jacob-rn-wallace/megadroid/SPEC.md

<!--
name: SPEC.md
type: specification
description: System specification: design intent and constraints
authority: authoritative
-->
# Megadroid — System Specification (SPEC)

**Status:** Authoritative  
**Scope:** Minimum Viable System (MVS)  
**Last rehydrated:** 2026-10-27

> **Note:** This document is a derived view of authoritative design data
> defined in `design/*.yaml`. See `REHYDRATE.md` for the rehydration process.

---

## 1. Purpose

This document defines the **authoritative system-level specification** for the Megadroid humanoid robot project.

It captures **design intent, architectural constraints, and locked assumptions** for the Minimum Viable System (MVS). All implementation details must conform to this specification unless explicitly revised here.

---

## 2. Project Goals

### 2.1 Ultimate Goal
To develop a **fully featured bipedal humanoid robot** with actuated legs, arms, and torso that can be built and iterated on by non-institutional builders at a fraction of the cost of traditional research humanoids.

### 2.2 Minimum Viable System (MVS) Goals
The MVS is intended to:
- Walk upright on flat ground
- Ascend and descend residential stairs using conservative, quasi-static gaits
- Maintain whole-body balance using limited actuation and software constraints
- Serve as a mechanically and electrically conservative foundation for future expansion

---

## 3. System Overview

### 3.1 Actuated Degrees of Freedom (MVS)

The following actuated degrees of freedom are derived directly from the
authoritative joint model defined in `design/joints.yaml`.

<!-- BEGIN AUTO-GENERATED: DOF -->
**Legs (×2):**
- Hip Yaw (yaw)
- Hip Pitch (pitch)
- Hip Roll (roll)
- Knee Pitch (pitch)
- Ankle Pitch (pitch)
- Ankle Roll (roll)

**Torso:**
- Torso Pitch (pitch)
- Torso Roll (roll)
- Torso Yaw (yaw)

**Total actuated DOF:** **15**
<!-- END AUTO-GENERATED: DOF -->

Each leg is a six-DOF leg: a three-axis hip (yaw, roll and pitch axes meeting at one point),
a knee, and a two-axis ankle. Hip yaw was added by the 2026-10-27 design revision; the legs
previously had five actuated DOF. The walking controllers do not yet use it (they hold it at
zero), so yaw steering and turning are not yet demonstrated in simulation.

### 3.2 Modular / Swappable Lower-Leg Assemblies (MVS vs Full System)

The robot supports modular lower-leg assemblies. The MVS lower-leg module includes both ankle pitch and ankle roll as actuated joints — see Section 5 for the reasoning. A passive, spring-centered ankle roll remains a possible future simplification, not a committed plan; the module boundary is kept compatible with it without requiring redesign of the pelvis, thigh, knee, or control stack.

### 3.3 Out-of-Scope (MVS)
- Arms: not installed in the MVS.

---

## 4. Anthropometrics

- Thigh length (hip → knee): defined in `design/geometry.yaml`
- Shin length (knee → ankle): defined in `design/geometry.yaml`
- Ankle-to-sole offset: defined in `design/geometry.yaml`

Overall body proportions are humanoid and sized to comfortably navigate residential environments (e.g., standard doorways, stairs).

---

## 5. Feet and Ground Contact

- Foot type (MVS module): Flat sole plate, resting on its bottom face, with a compliant
  sole pad for vertical shock absorption
- Ankle roll: sits between ankle pitch and the F/T sensor — see `design/joints.yaml`.
  It is **actuated**, kept that way deliberately for the time being: it was first
  actuated because a passive spring-centered ankle roll left the foot free to
  wobble uncontrolled and the gait fell over, and push-recovery investigation
  since then confirms actuated ankle/hip/torso roll axes are the physically
  correct authority for lateral disturbance recovery, matching capturability
  theory and real hardware. It is driven by the same generic position servo as
  every other joint. A passive, spring-centered ankle roll remains a possible
  future simplification, not a committed direction (see `tools/CLAUDE.md`).
- Function:
  - Vertical shock absorption (compliant sole pad)
  - Tolerance of foot placement errors
- End-of-limb sensing (6-DOF force/torque sensor per foot): see Section 7.3

---

## 6. Actuation

### 6.1 Motors
- All actuators use **775 brushed DC motors**
- Nominal motor voltage: **24 V**
- Motors mounted as proximally as possible to minimize distal inertia
- Total motor count (MVS): **15**

### 6.2 Gear Reduction
- Standardized gearbox classes reused across joints
- Gearbox class: **20:1 planetary**
- No joint uses a bespoke, one-off gearbox design
- Total drivetrain reduction: **80:1**
- All belt-driven transmission stages use HTD 5M timing belts with standardized width
  as defined in `design/geometry.yaml`.
- Belt stages provide additional reduction — belts exist to mount motors proximally, keeping mass off the distal links.
- Belt pitch and width are standardized across all joints to minimize part count,
  simplify sourcing, and improve serviceability.

### 6.3 Output Torque Envelope
- Peak sustained joint torque: **11.2 N·m** at every actuated joint
- A single envelope applies to all joints, since one motor and one gearbox class are used throughout
- This envelope is enforced in simulation as an actuator force limit, so simulated
  results reflect a bounded drivetrain rather than unlimited torque
- Motor stall torque, no-load speed, and drivetrain efficiency are currently
  estimates pending physical verification — see `design/actuation.yaml`, which also
  records what this model does **not** capture (torque–speed droop, thermal limits, belt compliance)
---

## 7. Sensors

### 7.1 Joint Position Sensing
- **Joint-mounted absolute encoders only**
- Encoders measure **true joint output angle**
- No motor-mounted encoders are permitted

### 7.2 Motor Sensing
- No motor current sensing
- No motor-side velocity sensing

### 7.3 Inertial Sensing
- **6-axis IMU** — gyroscope + accelerometer
- Mounting: pelvis, at the pelvis_center base frame origin
- **No magnetometer** — brushed DC motors make indoor magnetic heading unreliable; relative yaw is recovered from leg odometry against the planted foot, with slow absolute-yaw drift accepted
- IMU is **included in MVS cost accounting**
- Rationale: pelvis orientation and centre-of-mass velocity are required feedback states for every model-based balance method this design targets, and are not observable from joint encoders and foot force/torque alone
### 7.4 End-of-Limb Force/Torque Sensing
- Each foot includes a **6-DOF force/torque sensor**
- Form factor: hexagonal prism, 88.85mm across flats (inside a 107mm circumscribing diameter) × 57.544mm height
- Mounting: distal_face_of_lower_leg_module
- Sensor geometry is treated as a hard mechanical constraint
- F/T sensors are **excluded from MVS cost accounting**
- Rationale: excluded because the real cost is near zero, not because it is out of scope — each 6-DOF sensor is built from six load cells harvested from used Wii Fit Balance Boards (four bar-type cells per board), Stewart-platform arranged between two machined discs; three boards supply both feet's sensors at well under $100 each. The signal-chain electronics this requires are a separate, real cost not covered by this exclusion.

---

## 8. Control Architecture

### 8.1 Control Mode
- **Position-only control**
- No torque control
- No impedance control

### 8.2 Software Constraints
Stability and hardware protection are enforced through:
- Joint velocity limits
- Joint acceleration limits
- Gait timing constraints
- Brownout-aware behavior

---

## 9. Electrical Power System

### 9.1 Battery (Excluded from Cost Target)
- Model: **Toro 88675**
- Nominal voltage: **60 V**
- Capacity: **7.5 Ah**
- Energy: **405 Wh**

### 9.2 Power Distribution
- Single central DC/DC converter
- Conversion: **60 V → 24 V**
- Continuous current capability: ≥ **50 A**
- 24 V bus distributed to all motor drivers

### 9.3 Protection Philosophy
- Hardware current limiting at motor drivers
- Single main fuse on 60 V rail
- No per-motor DC/DC converters

---

## 10. Control Hardware Stack

### 10.1 High-Level Control
- **Raspberry Pi (Linux SBC)**
- Responsibilities:
  - Gait state machine
  - Trajectory generation
  - Supervisory control
  - Logging and debugging

### 10.2 Real-Time Control
- **3 × Waveshare RP2350-CAN boards**
  - Left leg controller
  - Right leg controller
  - Torso controller

### 10.3 Communications
- CAN bus
- Nominal bitrate: **500 kbps**

---

## 11. Cost Constraints

- **Target total system cost:** Comparable to a capable hobbyist desktop PC —
  approximately **$800–$1,500 USD** as of 2026
- The constraint is hobbyist accessibility, not a specific dollar figure. The
  question to ask of any component choice is: could an individual hobbyist
  justify this purchase without it being a significant financial decision?
- Explicit exclusions:
  - Battery
  - End-of-limb force/torque sensors
- Cost tracking is maintained in `BOM.csv`

---

## 12. Explicit Exclusions (MVS)

The following are intentionally excluded from the MVS:
- Arms or manipulators
- Torque or impedance control
- Motor current telemetry
- High-bandwidth force feedback loops
- Aesthetic-driven enclosure geometry

---

## 13. Design Philosophy

Megadroid prioritizes:
- Mechanical conservatism
- Electrical simplicity
- Software-enforced safety and stability
- Clear load paths and inspectable structures
- Incremental extensibility without redesign

For the full rationale behind these principles and the project's design
decisions, see `PHILOSOPHY.md`.

---

## 15. Change Control

### 15.1 Purpose

This section defines the **formal process by which changes to the Megadroid system specification are proposed, reviewed, and adopted**.

The intent is to:
- Prevent uncontrolled design drift
- Maintain consistency across `SPEC.md`, `MECH.md`, and `BOM.csv`
- Ensure that all changes are intentional, documented, and traceable

This process is intentionally lightweight and optimized for a small, fast-moving project.

### 15.2 Change Authority

- **`SPEC.md` is the highest authority** for the Megadroid MVS.
- Any change that alters:
    - system capabilities,
    - degrees of freedom,
    - architectural assumptions,
    - control philosophy,
    - or cost constraints
      **must be reflected in `SPEC.md`.**

`MECH.md` and `BOM.csv` **must not contradict `SPEC.md`**.

### 15.3 Changes Requiring a SPEC Revision

A modification **requires a `SPEC.md` update** if it affects any of the following:
- Actuated or passive degrees of freedom
- Joint limits or kinematic conventions
- Control mode (e.g., position vs torque)
- Power architecture or voltage levels
- Sensor strategy (e.g., encoder placement, sensing modality)
- Modularity assumptions (e.g., swappable lower-leg modules)
- Explicit inclusions or exclusions in the MVS
- Cost target or cost exclusions

Pure implementation details that do **not** affect these constraints belong in `MECH.md` or `BOM.csv` only.

### 15.4 Change Workflow

All design changes follow this sequence:

1. Proposal
   - Identify the motivation for change (e.g., feasibility, cost, packaging, precedent)
   - Articulate the proposed modification clearly
2. Evaluation
   - Assess impact on:
       - mechanical design
       - control strategy
       - cost target
       - future extensibility
   - Compare against relevant prior art where applicable
3. Specification Update
	- Modify `SPEC.md` to reflect the new or revised constraint.
    - Changes must be explicit and unambiguous.
4. Propagation
	- Update `MECH.md` and/or `BOM.csv` as required to conform to the new SPEC.
    - No document may remain in conflict with `SPEC.md`.
5. Commit
	- Commit changes to the repository with a clear message describing:
        - what changed
        - why it changed
        - what assumptions were updated or removed
   
### 15.5 Locked vs Revisable Decisions

Design decisions fall into two categories:

**Locked decisions**
- Explicitly stated as "locked" in `SPEC.md` or `MECH.md`
- Not revised without strong justification
- Changes require a SPEC revision and a commit explaining the rationale

**Revisable decisions**
- Identified as implementation details
- May evolve without changing `SPEC.md`
- Must remain compliant with all locked constraints

When in doubt, treat a decision as **locked**.

### 15.6 Versioning and Tags

- Git tags represent **stable design plateaus**, not incremental progress.
- A tag should only be created when:
    - `SPEC.md`, `MECH.md`, and `BOM.csv` and internally consistent
    - No known contradictions exist between documents

Tags serve as historical reference points and rollback anchors.

### 15.7 Conversational and External Inputs

Design discussions, simulations, analyses, and external references (including LLM-assisted reasoning) are **non-authoritative inputs**.

A design decision becomes authoritative **only when it is written into `SPEC.md` and committed to the repository**.

### 15.8 Guiding Principle

> If a decision matters, it must be written down.
> If it is written down, it must be respected.

This change control process exists to ensure that Megadroid evolves deliberately, not accidentally.

---

## 16. Authority

This document is **authoritative**.

All mechanical, electrical, and software implementations must conform to this specification unless a revision is made here.

Detailed mechanical implementation is defined in `MECH.md`.
