jacob-rn-wallace/megadroid/MECH.md

<!--
name: MECH.md
type: mechanical-design
description: Mechanical design: joints, structure, actuators, loads
authority: derived
-->
# Megadroid — Mechanical Design (MECH)

**Status:** Authoritative (MVS)  
**Scope:** Mechanical implementation details for the Minimum Viable System  
**Last rehydrated:** 2026-10-27

> **Note:** This document is a derived view of authoritative design data
> defined in `design/*.yaml`. See `REHYDRATE.md` for the rehydration process.

---

## 1. Purpose

This document defines the **authoritative mechanical design** of the Megadroid humanoid robot for the Minimum Viable System (MVS).

It specifies _how_ the system described in `SPEC.md` is physically realized, including joint layout, structural concepts, actuator placement, and load paths. Any mechanical implementation must conform to this document unless explicitly revised here.

---

## 2. Overall Mechanical Architecture

### 2.1 Structural Philosophy

Megadroid adopts a **mechanically conservative, inspection-friendly architecture** based on:
- Explicit load paths
- Double-shear joints wherever possible
- Proximal motor placement
- Reuse of structural and actuation patterns

The robot is organized around three primary structural modules:
- **Torso module** (houses power electronics and torso actuators)
- **Left leg module**
- **Right leg module**

Arms are excluded from the MVS. Ankle pitch and ankle roll are both actuated — ankle
roll is kept actuated deliberately for the time being (see Section 5.4).

---

## 3. Leg Architecture (MVS)

### 3.1 Degrees of Freedom per Leg

Each leg implements **six actuated DOF**:
- Hip yaw
- Hip roll
- Hip pitch
- Knee pitch
- Ankle pitch
- Ankle roll — **interim actuation** (see Section 5.4): temporarily motorized rather
  than passive/spring-centered, pending walking-controller work. See
  `design/joints.yaml` (`ankle_roll`).

Hip yaw was added in the 2026-10-27 design revision, taking the legs from five to six
actuated DOF. See Section 5.2.

The lower-leg module's knee-to-module mechanical interface is preserved, so a future
variant can return ankle roll to a passive, spring-centered joint without redesigning
the pelvis, thigh, knee, or ankle pitch assembly.

---

## 4. Leg Structural Construction

### 4.1 Twin-Rail / Box-Bulkhead Construction

Each leg segment (thigh and shank) is constructed as a **stiff boxed structure** using **twin longitudinal side rails** connected by **transverse bulkheads**, rather than a single tube or cosmetic shell.

- Rails are flat plates (e.g., aluminum or steel) arranged in parallel
- Bulkheads act as:
  - Structural diaphragms
  - Shaft and bearing mounting points
  - Load-transfer elements between rails
- Inner-face spacing between rails: defined in `design/geometry.yaml` (locked)

This architecture provides:
- High bending stiffness
- Good torsional rigidity when skinned
- Tolerance to fabrication variability
- Clear, inspectable load paths

Where beneficial, thin cover plates or printed skins may be added to form a closed box section and improve torsional stiffness.

### 4.2 Thigh Segment

- Length (hip → knee): defined in `design/geometry.yaml`
- Contains:
  - Hip pitch output shaft
  - Hip roll output shaft (carried on the hip yaw link above the thigh, Section 5.2)
  - Proximal portion of knee actuator (if applicable)

Motors are mounted as proximally as possible to reduce distal inertia.

### 4.3 Lower-Leg Module (Shank)

The lower-leg module consists of the complete shank structural assembly from the knee output interface down to its distal termination bulkhead.

**Structural stack (proximal → distal):**
1. Knee output interface
2. Shank twin rails (length defined in `design/geometry.yaml`)
3. Ankle pitch joint assembly
4. Ankle roll joint assembly (actuated — interim, see Section 5.4)
5. Distal termination bulkhead
6. F/T sensor (mounted to distal bulkhead face)
7. Foot sole plate (MVS)

**Key characteristics:**
- Modular: swappable at knee interface without redesigning pelvis, thigh, or knee
- MVS configuration: includes actuated ankle pitch and ankle roll (ankle roll's
  actuation is interim — see Section 5.4)
- Future configurations: planned to return ankle roll to a passive, spring-centered
  joint while preserving the knee-to-module interface
- Contains knee pitch output shaft
- Distal bulkhead provides mounting face for end-of-limb F/T sensor

---

## 5. Joint Design

### 5.1 General Joint Requirements

All joints must:
- Use **joint-mounted absolute encoders**
- Measure true joint output angle
- Be serviceable and inspectable
- Carry primary loads in double shear

Motor-mounted encoders are explicitly disallowed.

This applies uniformly regardless of whether a given joint is actuated in the current
configuration — true output angle is needed for accurate foot-orientation and ZMP
calculations either way, so every joint carries the same joint-mounted absolute
encoder.

### 5.2 Hip Joint Assembly

The hip consists of **three orthogonal rotational axes** that meet at one point, in this
chain order from the pelvis outward:

- **Hip yaw** (turning the leg about the vertical axis)
- **Hip roll** (lateral balance)
- **Hip pitch** (sagittal plane motion)

Key characteristics:
- Motors mounted proximally (pelvis, hip yaw link or upper thigh)
- The hip yaw motors sit in the pelvis. The hip roll motor rides on the hip yaw link and
  turns with it, so the hip yaw output shaft carries the roll motor's weight
- Gearboxes coupled directly to joint output shafts
- Bearings sized for combined radial and moment loads

Hip yaw is an actuated MVS joint (design revision 2026-10-27; it was previously described
here as present but locked). The current walking controllers hold it at zero, so turning is
not yet demonstrated in simulation.

Hip joint output shafts use standardized shafting as defined in `design/geometry.yaml` (locked) to standardize bearings, hubs, and pulley bores.

### 5.3 Knee Joint Assembly

- Single-axis revolute joint (pitch)
- Actuator mounted proximally in the thigh
- Torque transmitted across the joint via a rigid shaft
- Bearings sized primarily for bending loads from stance phase

### 5.4 Lower-Leg Module and Foot Interface (MVS)

The MVS lower-leg module includes actuated ankle pitch and ankle roll, kept actuated deliberately for the time being, while preserving the mechanical interface for a possible future reversion to a passive design.

**Module definition:**
The lower-leg module includes the shank twin rails, ankle pitch joint assembly, ankle roll joint assembly, all bulkheads, and the distal termination bulkhead that serves as the mounting face for the F/T sensor.

**Structural boundaries:**
- Proximal: knee output interface
- Distal: F/T sensor mounting face (distal termination bulkhead)

**MVS configuration:**
- Ankle pitch actuated
- Ankle roll actuated — **interim** (see `design/joints.yaml`): simulation found the
  walking controllers have no lateral feedback, so a passive spring-centered ankle
  roll left the gait unstable; temporarily motorized pending either a validated
  spring or real local lateral feedback (`tools/CLAUDE.md`)
- Flat sole foot plate mounted distal to F/T sensor

**Future compatibility:**
A future lower-leg module is planned to return ankle roll to a passive,
spring-centered joint while preserving:
- Same knee-to-module mechanical interface
- Same joint encoder strategy
- Compatibility with pelvis, thigh, and knee assemblies

---

## 6. End-of-Limb Force/Torque Sensor Integration

Each foot has one **6-DOF force/torque sensor** that measures ground reaction forces and moments.

**Mounting and integration:**
- Sensor is mounted directly to the distal termination bulkhead of the lower-leg module
- Located immediately proximal to the foot/end-effector, distal to both ankle pitch and ankle roll
- Form factor: hexagonal prism, 88.85mm across flats (inside a 107mm circumscribing diameter) × 57.544mm height (defined in `design/sensors.yaml`)
- Mechanical constraint: treated as hard structural envelope

**Load path requirements:**
- Ground reaction forces must pass axially through the sensor
- Structural design must avoid imposing parasitic bending moments on sensor body
- Sensor sits between distal bulkhead and foot in the structural stack

**Cost accounting:**
F/T sensors are mechanically required but **excluded from cost accounting** —
not because they are out of scope, but because the real cost is near zero.
Each sensor is built from six load cells harvested from used Wii Fit Balance
Boards (four bar-type cells per board), arranged Stewart-platform style
between two custom-machined aluminium discs within the envelope above; three
boards (twelve cells) supply both feet's sensors at well under $100 each.
The signal-chain electronics this sourcing needs (multi-channel amplification
and fast acquisition) are a separate, real cost not covered by this exclusion
— see `docs/P4_JOINT_TEST_RIG.md`.

---

## 6a. Inertial Sensor Integration

A single **6-axis IMU** (gyroscope + accelerometer) is mounted at the pelvis.

**Mounting and integration:**
- Location: pelvis, at the pelvis_center base frame origin
- Co-locating the IMU with the base frame origin means its measurements need no transform before use — readings are already expressed about the frame the kinematics are defined in
- Should be mounted on the pelvis structure rather than on a motor bracket, to keep brushed-motor vibration out of the accelerometer signal
- Rigid mounting is required: any compliance between the IMU and the pelvis structure appears directly as orientation error

**Function:**
Provides pelvis orientation and angular rate. Together with joint encoders and the
foot force/torque sensors, this is what makes centre-of-mass position and velocity
observable — neither is recoverable from encoders and foot sensing alone, and both are
required feedback states for the balance methods this design targets.

**Cost accounting:**
The IMU is **included in cost accounting**, unlike the F/T sensors.
---

## 7. Actuator Integration

### 7.1 Motors

- All actuators use **775 brushed DC motors**
- Motors mounted proximally where feasible
- Motors mechanically isolated from bending loads

### 7.2 Gearboxes

- Modular gearbox designs reused across joints
- Gearbox class: **20:1 planetary**, reused at every actuated joint
- Only a small number of gearbox ratios permitted
- No joint-specific one-off gearbox designs

Exact gearbox part selections are documented in `BOM.csv`.

### 7.3 Belt Standard (Locked)

All belt stages in Megadroid use HTD 5M timing belts with standardized width as defined in `design/geometry.yaml`.

Belt stages provide additional reduction on top of the gearbox.
### 7.4 Output Torque Envelope

- Total reduction: **80:1**
- Peak joint torque: **11.2 N·m**, uniform across all actuated joints
- Maximum joint speed: **19.6 rad/s**

This envelope bounds what any control strategy can demand of a joint, and is enforced
as an actuator limit in the generated simulation model. Motor stall torque, no-load
speed, and drivetrain efficiency are estimates pending physical measurement — see
`design/actuation.yaml` for the values, their provenance, and the effects this model
deliberately does not capture (torque–speed droop, thermal limits, belt compliance,
gear backlash).

---

## 8. Torso Mechanical Design

### 8.1 Degrees of Freedom

The torso implements **three actuated DOF**:
- Pitch
- Roll
- Yaw

### 8.2 Structural Role

The torso structure:
- Serves as the primary load path between legs
- Houses power electronics and controllers
- Provides mounting for torso actuators

The torso must maintain stiffness sufficient to prevent coupling between leg motions through structural flex.

---

## 9. Materials and Fabrication

### 9.1 Preferred Materials

- Aluminum plate for primary structure
- Steel shafts and fasteners
- Polymer or printed parts only where loads are low

Pultruded carbon tubes are explicitly excluded from the MVS.

### 9.2 Fabrication Philosophy

Designs should favor:
- Flat plate machining or waterjet
- Off-the-shelf bearings and fasteners
- Minimal custom machining
- Tolerance-insensitive assemblies

---

## 10. Mechanical Constraints

- Must fit through standard residential doorways
- Must tolerate quasi-static stair climbing loads
- Must support conservative gait speeds

---

## 11. Authority

This document is a **derived view** of the authoritative design data in `design/*.yaml` and `SPEC.md`.

Any mechanical change must first be reflected in the appropriate YAML files and `SPEC.md`, then propagated here via rehydration.
