jacob-rn-wallace/megadroid/hardware/ft_sensor/cad/megadroid_ft_v0/features.csv

member | cell_on | tilt_from_cap_normal_deg | azimuth_deg | u_x | u_y | u_z | wedge_hole_entry_x | wedge_hole_entry_y | wedge_hole_entry_z | boss_hole_entry_x | boss_hole_entry_y | boss_hole_entry_z
0 | bottom | 54.50 | 111.0 | -0.2918 | 0.7600 | 0.5807 | 25.591 | 25.604 | 5.020 | 23.068 | 32.178 | 46.893
1 | top | 54.50 | -69.0 | 0.2918 | -0.7600 | -0.5807 | -25.591 | -25.604 | 46.524 | -23.068 | -32.178 | 4.651
2 | bottom | 54.50 | -129.0 | -0.5123 | -0.6327 | 0.5807 | -34.970 | 9.361 | 5.020 | -39.401 | 3.888 | 46.893
3 | top | 54.50 | 51.0 | 0.5123 | 0.6327 | -0.5807 | 34.970 | -9.361 | 46.524 | 39.401 | -3.888 | 4.651
4 | bottom | 54.50 | -9.0 | 0.8041 | -0.1274 | 0.5807 | 9.378 | -34.965 | 5.020 | 16.333 | -36.066 | 46.893
5 | top | 54.50 | 171.0 | -0.8041 | 0.1274 | -0.5807 | -9.378 | 34.965 | 46.524 | -16.333 | 36.066 | 4.651
