jacob-rn-wallace/megadroid/BOM.csv

<!--
name: BOM.csv
type: data
description: Bill of materials and cost tracking for MVS
authority: derived
-->
Subsystem | Item | Quantity | UnitCostUSD | ExtendedCostUSD | CostIncluded | Notes
Actuation | 775 Brushed DC Motor | 15 | 18 | 270 | Yes | Identical motor used for all actuated joints — includes hip_yaw (added 2026-10-27 for 6-DOF legs) and ankle_roll (temporarily actuated | see design/joints.yaml)
Actuation | 20:1 Planetary Gearbox (775 compatible) | 15 | 25 | 375 | Yes | Standardized gearbox class reused across joints
Actuation | Secondary Belt Reduction Components (4:1) | 15 | 12 | 180 | Yes | 4:1 belt on ALL actuated joints incl. ankles — ankle-less scope never walks at any ratio (design/actuation.yaml)
Sensors | Absolute Joint Encoder | 15 | 8 | 120 | Yes | Joint-mounted output encoders — all 15 actuated joints (design/sensors.yaml)
Sensors | 6-Axis IMU (gyro + accelerometer) | 1 | 15 | 15 | Yes | Pelvis-mounted at base frame origin; no magnetometer (design/sensors.yaml)
Control | Waveshare RP2350-CAN Controller | 3 | 22 | 66 | Yes | Left leg | right leg | torso
Control | Raspberry Pi (Linux SBC) | 1 | 45 | 45 | Yes | High-level control and supervision
Power | 60V to 24V DC/DC Converter (≥50A) | 1 | 85 | 85 | Yes | Centralized power conversion
Power | Main Fuse and Power Distribution Hardware | 1 | 25 | 25 | Yes | 60V rail protection and wiring
Structure | Aluminum Plate Stock (Legs + Torso) | 1 | 120 | 120 | Yes | Twin-rail box-bulkhead construction
Structure | Bearings | Shafts | Fasteners (Bulk) | 1 | 110 | 110 | Yes | Shared across joints and structure
Feet | Flat Sole Plate Assembly (compliant sole pad) | 2 | 30 | 60 | Yes | Rigid plate + compliant pad for vertical shock absorption
Feet | 6-DOF Force/Torque Sensor | 2 | 0 | 0 | No | Excluded because real cost is near-zero — built from 6 harvested Wii Fit Balance Board load cells each (design/sensors.yaml)
Power | Toro 88675 Battery Pack | 1 | 0 | 0 | No | Excluded from cost target per SPEC
TOTAL
