jacob-rn-wallace/megadroid/hardware/ft_sensor/cad/megadroid_ft_v0/sensor_assembly.step

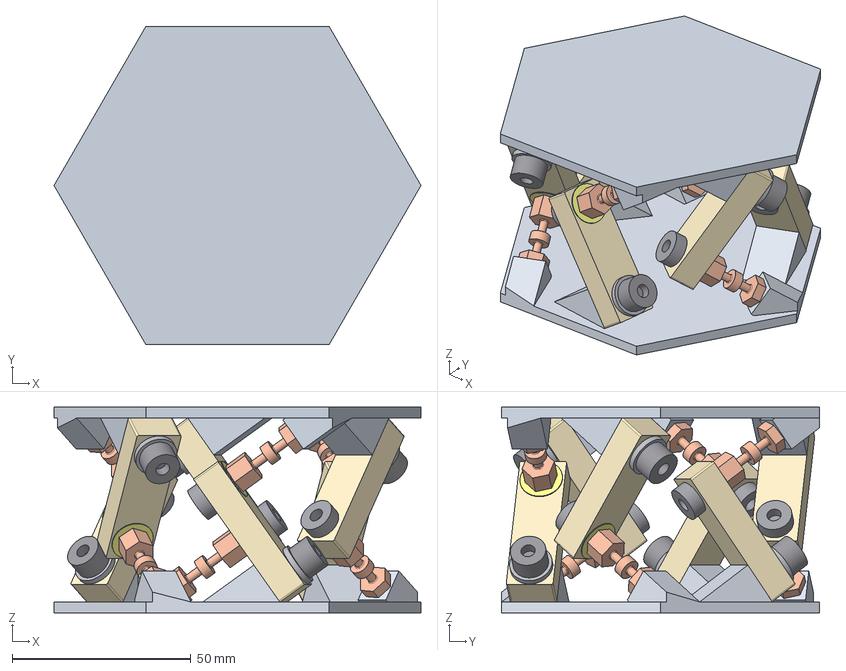
[picture p1: CAD file, 2026-10-21]
hardware/ft_sensor/cad/megadroid_ft_v0/sensor_assembly.step
102.6 x 88.8 x 57.5 mm
cap_bottom
cap_top
cell_0
cell_1
cell_2
cell_3
cell_4
cell_5
rod_5 x 6
bolt_0
washer_fixed_0
shim_0
screw_free_0
bolt_1
washer_fixed_1
shim_1
screw_free_1
bolt_2
washer_fixed_2
shim_2
screw_free_2
bolt_3
washer_fixed_3
shim_3
screw_free_3
bolt_4
washer_fixed_4
shim_4
screw_free_4
bolt_5
washer_fixed_5
shim_5
screw_free_5
