jacob-rn-wallace/megadroid/hardware/ft_sensor/cad/bench_rigs/parts/block_a2.step

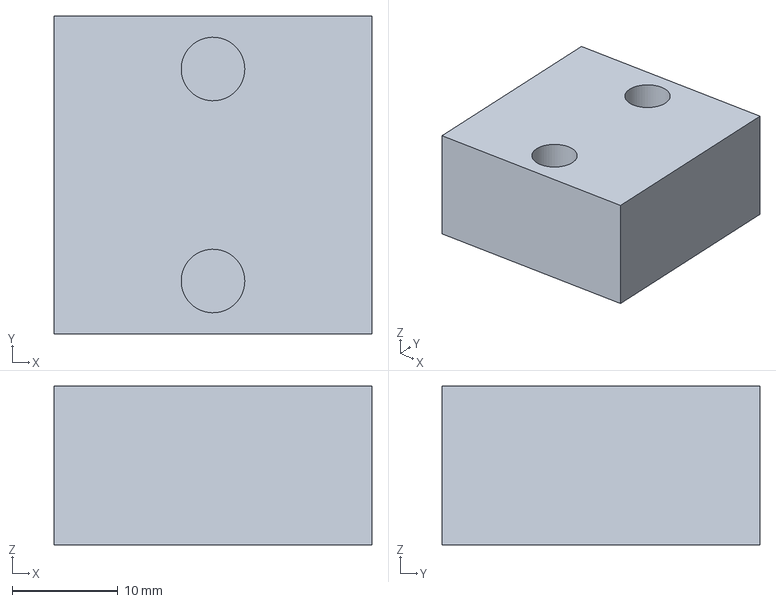
[picture p2: CAD file, 2026-10-22]
hardware/ft_sensor/cad/bench_rigs/parts/block_a2.step
30.0 x 30.0 x 15.0 mm
