jacob-rn-wallace/megadroid/hardware/ft_sensor/cad/bench_rigs/rig_R_strut.step

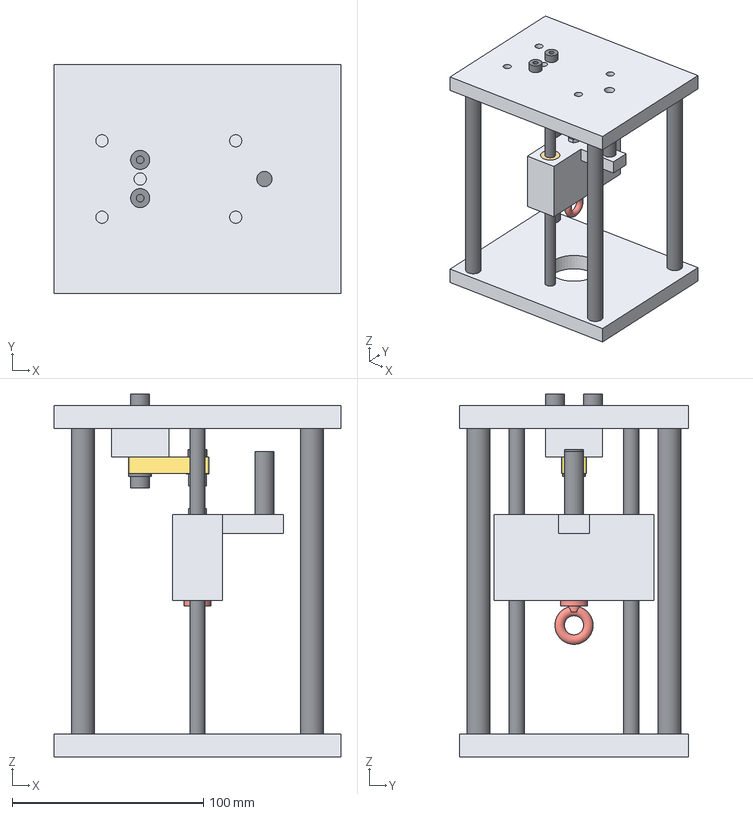
[picture p3: CAD file, 2026-10-22]
hardware/ft_sensor/cad/bench_rigs/rig_R_strut.step
150.0 x 120.0 x 190.0 mm
top_plate
column_0
column_1
column_2
column_3
bottom_plate
block_a2
attach_screw_n
attach_screw_p
cell
washer
cell_bolt
shim
rod
free_screw
carriage_r
shaft_0
bushing_0
shaft_1
bushing_1
dial_post
eyebolt
