jacob-rn-wallace/megadroid/hardware/ft_sensor/cad/stewart_concept_2026-10-20.step

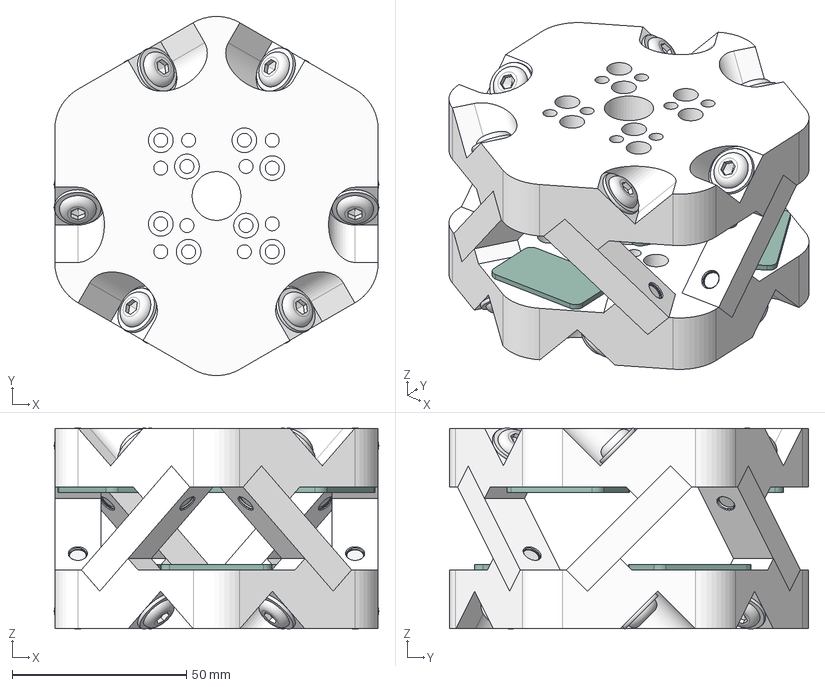
[picture p4: CAD file, 2026-10-21]
hardware/ft_sensor/cad/stewart_concept_2026-10-20.step
93.2 x 103.1 x 57.7 mm
MLC714N x 3
Half x 2
97654A225_18-8 Stainless Steel Flanged Button Head Screw x 6
MLC714N v1(Mirror) x 3
97654A225_18-8 Stainless Steel Flanged Button Head Screw_1 x 6
PCB x 6
