jacob-rn-wallace/megadroid/hardware/ft_sensor/cad/bench_rigs/parts/h3_lower_plate.step

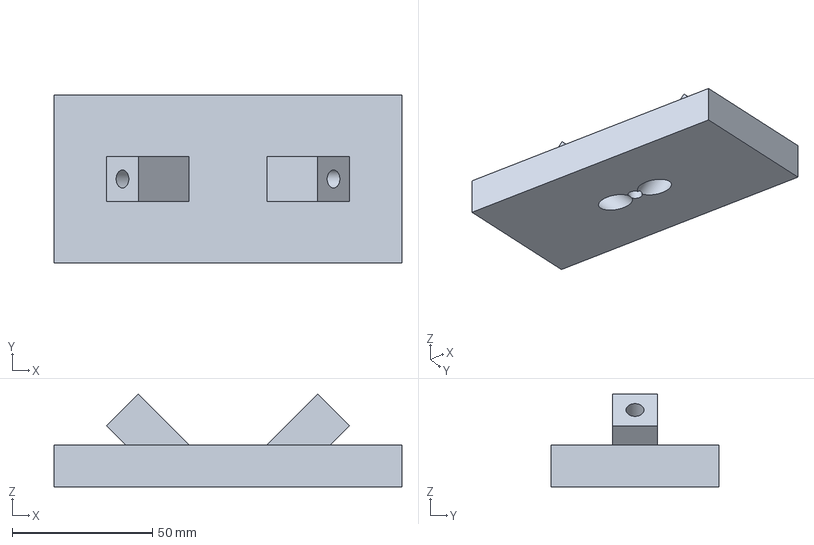
[picture p5: CAD file, 2026-10-22]
hardware/ft_sensor/cad/bench_rigs/parts/h3_lower_plate.step
124.0 x 60.0 x 33.0 mm
