jacob-rn-wallace/megadroid/hardware/ft_sensor/cad/bench_rigs/rig_H_cantilever.step

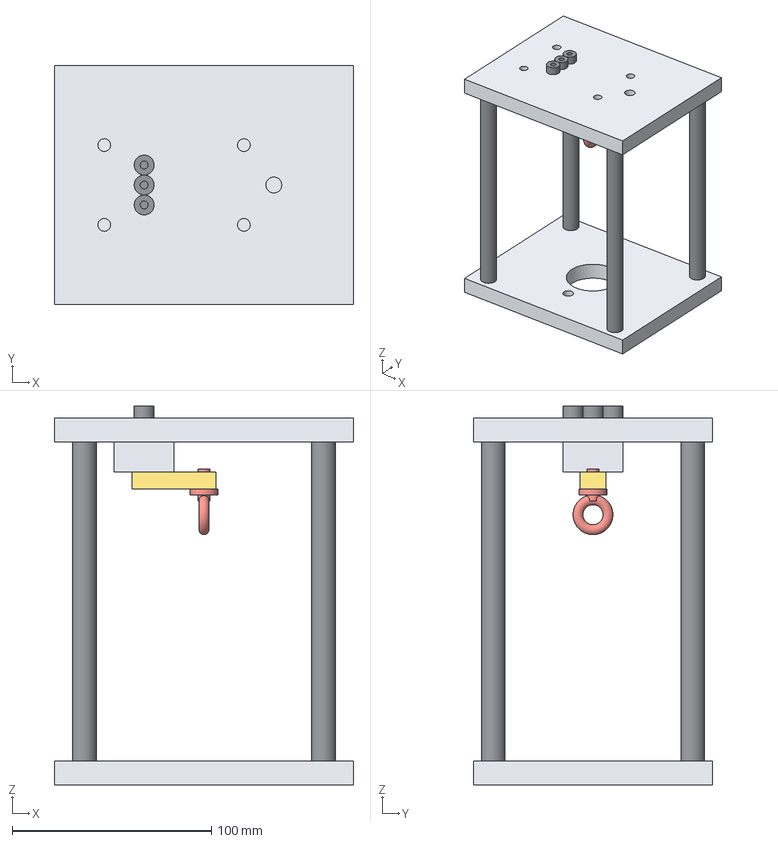
[picture p6: CAD file, 2026-10-22]
hardware/ft_sensor/cad/bench_rigs/rig_H_cantilever.step
150.0 x 120.0 x 190.0 mm
top_plate
column_0
column_1
column_2
column_3
bottom_plate
block_a1
attach_screw_n
attach_screw_p
cell
cell_screw
eyebolt
