jacob-rn-wallace/megadroid/hardware/ft_sensor/cad/megadroid_ft_v0/load_cell_modified.step

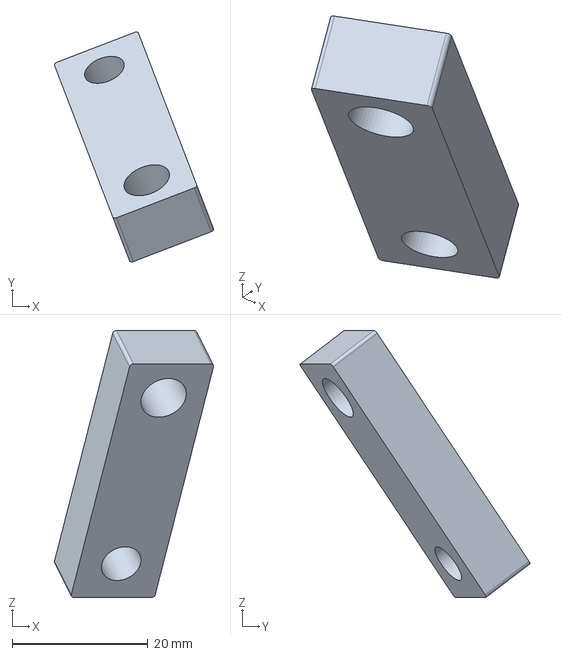
[picture p7: CAD file, 2026-10-21]
hardware/ft_sensor/cad/megadroid_ft_v0/load_cell_modified.step
23.5 x 33.9 x 39.3 mm
