jacob-rn-wallace/megadroid/hardware/ft_sensor/cad/bench_rigs/parts/rod.step

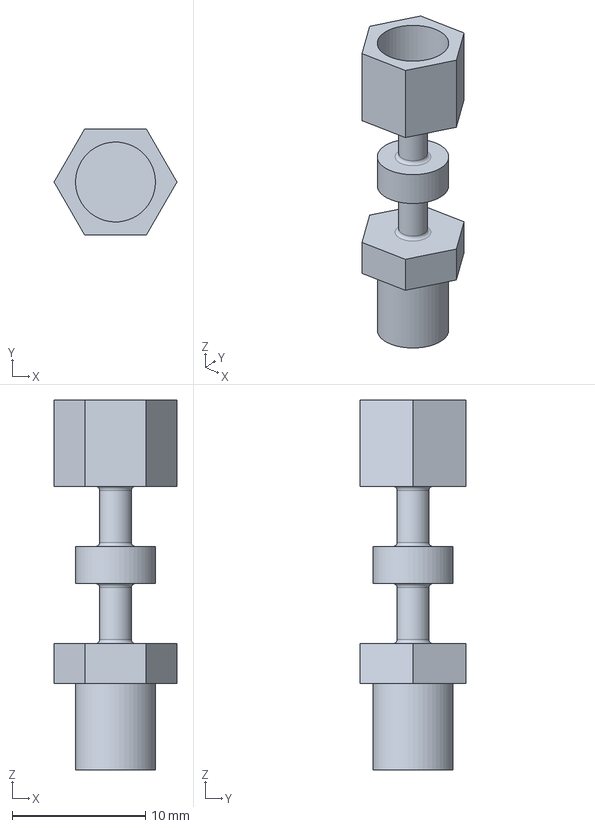
[picture p8: CAD file, 2026-10-22]
hardware/ft_sensor/cad/bench_rigs/parts/rod.step
9.24 x 8.00 x 27.8 mm
