jacob-rn-wallace/megadroid/hardware/ft_sensor/cad/megadroid_ft_v0/fasteners.step

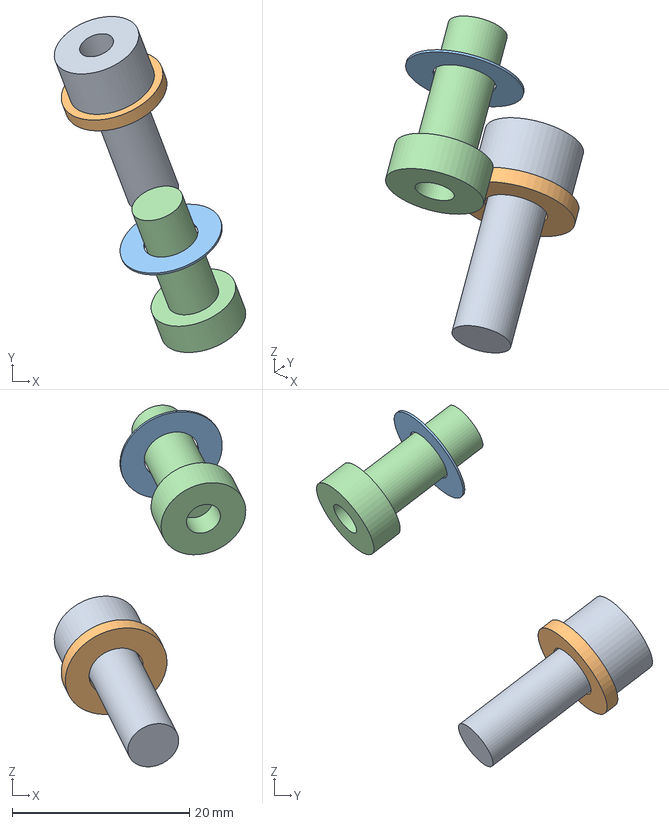
[picture p9: CAD file, 2026-10-21]
hardware/ft_sensor/cad/megadroid_ft_v0/fasteners.step
21.6 x 38.0 x 40.9 mm
