jacob-rn-wallace/megadroid/hardware/ft_sensor/cad/bench_rigs/parts/carriage_r.step

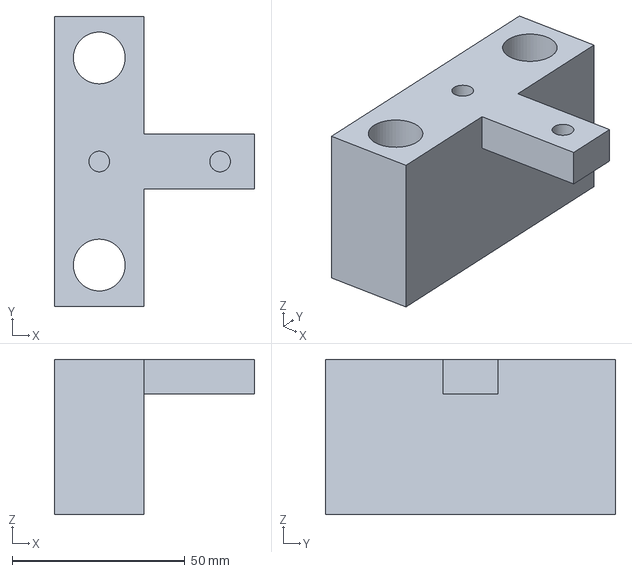
[picture p10: CAD file, 2026-10-22]
hardware/ft_sensor/cad/bench_rigs/parts/carriage_r.step
58.0 x 84.0 x 45.0 mm
