jacob-rn-wallace/megadroid/hardware/ft_sensor/cad/megadroid_ft_v0/cap_bottom.step

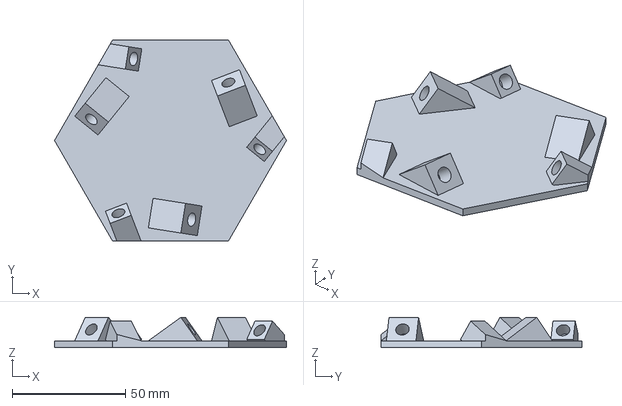
[picture p11: CAD file, 2026-10-21]
hardware/ft_sensor/cad/megadroid_ft_v0/cap_bottom.step
102.6 x 88.8 x 13.4 mm
