jacob-rn-wallace/megadroid/hardware/ft_sensor/cad/bench_rigs/rig_H3_vee.step

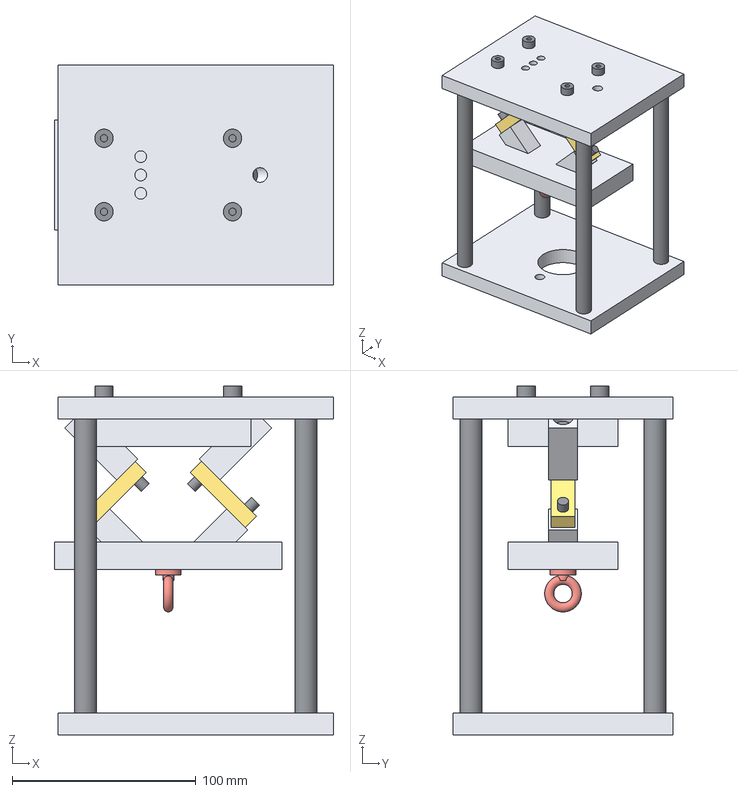
[picture p12: CAD file, 2026-10-22]
hardware/ft_sensor/cad/bench_rigs/rig_H3_vee.step
152.0 x 120.0 x 190.0 mm
top_plate
column_0
column_1
column_2
column_3
bottom_plate
h3_upper_plate
h3_lower_plate
plate_screw_0
plate_screw_1
plate_screw_2
plate_screw_3
eyebolt
cell_pos
screw_up_pos
screw_lo_pos
cell_neg
screw_up_neg
screw_lo_neg
