jacob-rn-wallace/megadroid/hardware/ft_sensor/cad/bench_rigs/parts/top_plate.step

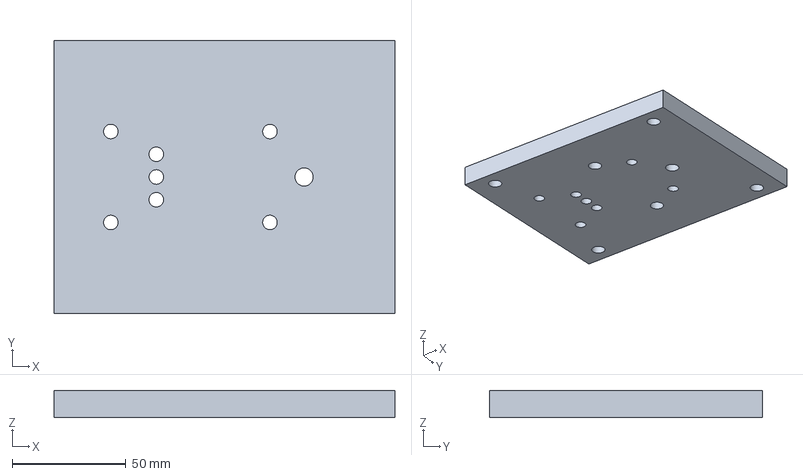
[picture p13: CAD file, 2026-10-22]
hardware/ft_sensor/cad/bench_rigs/parts/top_plate.step
150.0 x 120.0 x 12.0 mm
