jacob-rn-wallace/megadroid/hardware/ft_sensor/cad/bench_rigs/parts/block_a1.step

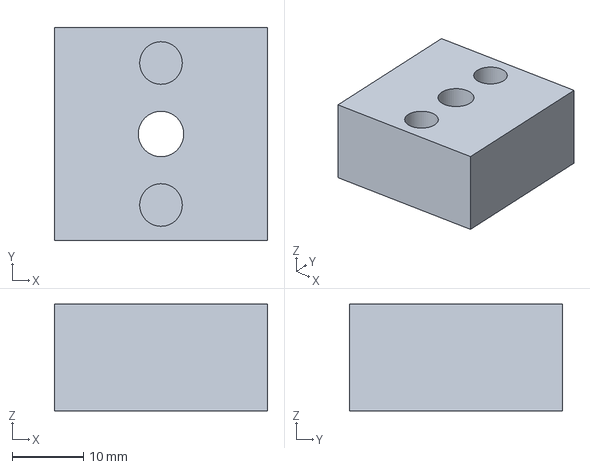
[picture p14: CAD file, 2026-10-22]
hardware/ft_sensor/cad/bench_rigs/parts/block_a1.step
30.0 x 30.0 x 15.0 mm
