jacob-rn-wallace/megadroid/hardware/ft_sensor/cad/bench_rigs/parts/block_a3.step

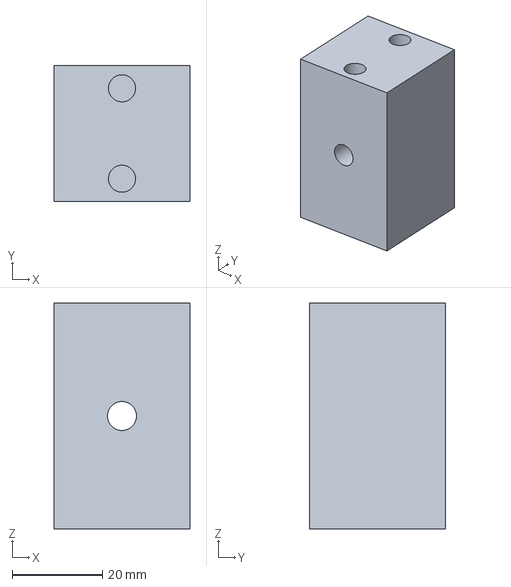
[picture p15: CAD file, 2026-10-22]
hardware/ft_sensor/cad/bench_rigs/parts/block_a3.step
30.0 x 30.0 x 50.0 mm
