jacob-rn-wallace/megadroid/hardware/ft_sensor/cad/bench_rigs/parts/h3_upper_plate.step

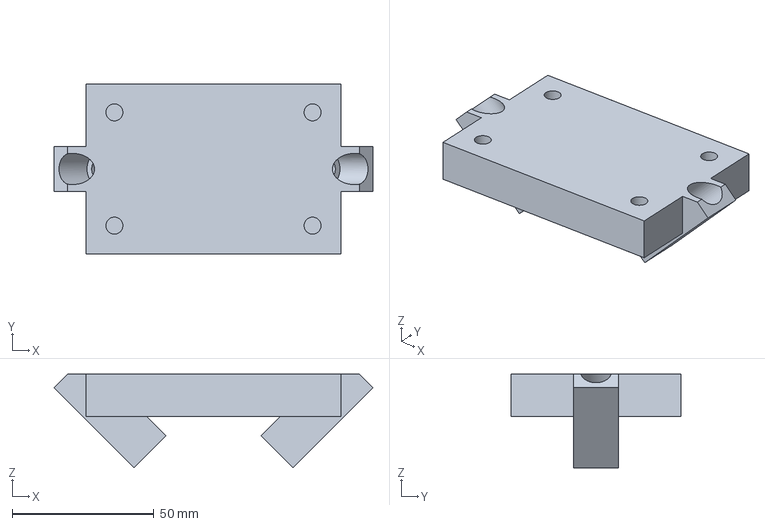
[picture p16: CAD file, 2026-10-22]
hardware/ft_sensor/cad/bench_rigs/parts/h3_upper_plate.step
112.7 x 60.0 x 33.0 mm
