jacob-rn-wallace/megadroid/(list of files, cad)

Other CAD files:
hardware/ft_sensor/cad/bench_rigs/rig_H_offaxis.step
hardware/ft_sensor/cad/bench_rigs/rig_H2_guided.step
hardware/ft_sensor/cad/bench_rigs/parts/carriage_h2.step
hardware/ft_sensor/cad/megadroid_ft_v0/rod.step
hardware/ft_sensor/cad/megadroid_ft_v0/cap_top.step
