jacob-rn-wallace/megadroid/simulation/urdf/megadroid_mvs.urdf

<?xml version="1.0" ?>
<robot name="megadroid_mvs">
  <link name="pelvis">
    <visual>
      <origin xyz="0 0 0" rpy="0 0 0"/>
      <geometry>
        <box size="0.20 0.30 0.15"/>
      </geometry>
      <material name="grey">
        <color rgba="0.5 0.5 0.5 1.0"/>
      </material>
    </visual>
    <inertial>
      <origin xyz="0.000000 0.000000 0.000000" rpy="0 0 0"/>
      <mass value="1.5"/>
      <inertia ixx="0.01406250" iyy="0.00781250" izz="0.01625000" ixy="0.00000000" ixz="0.00000000" iyz="0.00000000"/>
    </inertial>
  </link>
  <link name="torso_pitch_link">
    <visual>
      <origin xyz="0 0 0" rpy="0 0 0"/>
      <geometry>
        <box size="0.05 0.20 0.05"/>
      </geometry>
      <material name="grey">
        <color rgba="0.5 0.5 0.5 1.0"/>
      </material>
    </visual>
    <inertial>
      <origin xyz="0.000000 0.000000 0.000000" rpy="0 0 0"/>
      <mass value="0.3"/>
      <inertia ixx="0.00106250" iyy="0.00012500" izz="0.00106250" ixy="0.00000000" ixz="0.00000000" iyz="0.00000000"/>
    </inertial>
  </link>
  <joint name="torso_pitch_joint" type="revolute">
    <parent link="pelvis"/>
    <child link="torso_pitch_link"/>
    <origin xyz="0 0 0.075" rpy="0 0 0"/>
    <axis xyz="0 1 0"/>
    <limit lower="-0.5235987755982988" upper="0.5235987755982988" effort="11.2" velocity="19.6"/>
  </joint>
  <link name="torso_roll_link">
    <visual>
      <origin xyz="0 0 0" rpy="0 0 0"/>
      <geometry>
        <box size="0.05 0.20 0.05"/>
      </geometry>
      <material name="grey">
        <color rgba="0.5 0.5 0.5 1.0"/>
      </material>
    </visual>
    <inertial>
      <origin xyz="0.000000 0.000000 0.000000" rpy="0 0 0"/>
      <mass value="0.3"/>
      <inertia ixx="0.00106250" iyy="0.00012500" izz="0.00106250" ixy="0.00000000" ixz="0.00000000" iyz="0.00000000"/>
    </inertial>
  </link>
  <joint name="torso_roll_joint" type="revolute">
    <parent link="torso_pitch_link"/>
    <child link="torso_roll_link"/>
    <origin xyz="0 0 0" rpy="0 0 0"/>
    <axis xyz="1 0 0"/>
    <limit lower="-0.3490658503988659" upper="0.3490658503988659" effort="11.2" velocity="19.6"/>
  </joint>
  <link name="torso">
    <visual>
      <origin xyz="0 0 0.2" rpy="0 0 0"/>
      <geometry>
        <box size="0.15 0.25 0.40"/>
      </geometry>
      <material name="grey">
        <color rgba="0.5 0.5 0.5 1.0"/>
      </material>
    </visual>
    <inertial>
      <origin xyz="0.000000 0.000000 0.200000" rpy="0 0 0"/>
      <mass value="2.0"/>
      <inertia ixx="0.03708333" iyy="0.03041667" izz="0.01416667" ixy="0.00000000" ixz="0.00000000" iyz="0.00000000"/>
    </inertial>
  </link>
  <joint name="torso_yaw_joint" type="revolute">
    <parent link="torso_roll_link"/>
    <child link="torso"/>
    <origin xyz="0 0 0" rpy="0 0 0"/>
    <axis xyz="0 0 1"/>
    <limit lower="-0.7853981633974483" upper="0.7853981633974483" effort="11.2" velocity="19.6"/>
  </joint>
  <link name="left_hip_yaw_link">
    <visual>
      <origin xyz="0 0 0" rpy="0 0 0"/>
      <geometry>
        <sphere radius="0.03"/>
      </geometry>
      <material name="orange">
        <color rgba="0.8 0.4 0.1 1.0"/>
      </material>
    </visual>
    <inertial>
      <origin xyz="0.000000 0.000000 0.000000" rpy="0 0 0"/>
      <mass value="0.5"/>
      <inertia ixx="0.00018000" iyy="0.00018000" izz="0.00018000" ixy="0.00000000" ixz="0.00000000" iyz="0.00000000"/>
    </inertial>
  </link>
  <joint name="left_hip_yaw_joint" type="revolute">
    <parent link="pelvis"/>
    <child link="left_hip_yaw_link"/>
    <origin xyz="0 0.0875 0" rpy="0 0 0"/>
    <axis xyz="0 0 1"/>
    <limit lower="-0.5235987755982988" upper="0.5235987755982988" effort="11.2" velocity="19.6"/>
  </joint>
  <link name="left_hip_roll_link">
    <visual>
      <origin xyz="0 0 0" rpy="0 0 0"/>
      <geometry>
        <sphere radius="0.03"/>
      </geometry>
      <material name="orange">
        <color rgba="0.8 0.4 0.1 1.0"/>
      </material>
    </visual>
    <inertial>
      <origin xyz="0.000000 0.000000 0.000000" rpy="0 0 0"/>
      <mass value="0.3"/>
      <inertia ixx="0.00010800" iyy="0.00010800" izz="0.00010800" ixy="0.00000000" ixz="0.00000000" iyz="0.00000000"/>
    </inertial>
  </link>
  <joint name="left_hip_roll_joint" type="revolute">
    <parent link="left_hip_yaw_link"/>
    <child link="left_hip_roll_link"/>
    <origin xyz="0 0 0" rpy="0 0 0"/>
    <axis xyz="1 0 0"/>
    <limit lower="-0.5235987755982988" upper="0.5235987755982988" effort="11.2" velocity="19.6"/>
  </joint>
  <link name="left_thigh">
    <visual>
      <origin xyz="0 0 -0.15" rpy="0 0 0"/>
      <geometry>
        <cylinder radius="0.040" length="0.3"/>
      </geometry>
      <material name="blue">
        <color rgba="0.2 0.2 0.8 1.0"/>
      </material>
    </visual>
    <inertial>
      <origin xyz="0.000000 0.000000 -0.150000" rpy="0 0 0"/>
      <mass value="0.9"/>
      <inertia ixx="0.00711000" iyy="0.00711000" izz="0.00072000" ixy="0.00000000" ixz="0.00000000" iyz="0.00000000"/>
    </inertial>
  </link>
  <joint name="left_hip_pitch_joint" type="revolute">
    <parent link="left_hip_roll_link"/>
    <child link="left_thigh"/>
    <origin xyz="0 0 0" rpy="0 0 0"/>
    <axis xyz="0 1 0"/>
    <limit lower="-0.5235987755982988" upper="1.9198621771937625" effort="11.2" velocity="19.6"/>
  </joint>
  <link name="left_shin">
    <visual>
      <origin xyz="0 0 -0.15" rpy="0 0 0"/>
      <geometry>
        <cylinder radius="0.035" length="0.3"/>
      </geometry>
      <material name="blue">
        <color rgba="0.2 0.2 0.8 1.0"/>
      </material>
    </visual>
    <inertial>
      <origin xyz="0.000000 0.000000 -0.150000" rpy="0 0 0"/>
      <mass value="0.7"/>
      <inertia ixx="0.00546437" iyy="0.00546437" izz="0.00042875" ixy="0.00000000" ixz="0.00000000" iyz="0.00000000"/>
    </inertial>
  </link>
  <joint name="left_knee_pitch_joint" type="revolute">
    <parent link="left_thigh"/>
    <child link="left_shin"/>
    <origin xyz="0 0 -0.3" rpy="0 0 0"/>
    <axis xyz="0 1 0"/>
    <limit lower="0.0" upper="2.443460952792061" effort="11.2" velocity="19.6"/>
  </joint>
  <link name="left_ankle">
    <visual>
      <origin xyz="0 0 0" rpy="0 0 0"/>
      <geometry>
        <sphere radius="0.025"/>
      </geometry>
      <material name="orange">
        <color rgba="0.8 0.4 0.1 1.0"/>
      </material>
    </visual>
    <inertial>
      <origin xyz="0.000000 0.000000 0.000000" rpy="0 0 0"/>
      <mass value="0.35"/>
      <inertia ixx="0.00008750" iyy="0.00008750" izz="0.00008750" ixy="0.00000000" ixz="0.00000000" iyz="0.00000000"/>
    </inertial>
  </link>
  <joint name="left_ankle_pitch_joint" type="revolute">
    <parent link="left_shin"/>
    <child link="left_ankle"/>
    <origin xyz="0 0 -0.3" rpy="0 0 0"/>
    <axis xyz="0 1 0"/>
    <limit lower="-0.5235987755982988" upper="0.5235987755982988" effort="11.2" velocity="19.6"/>
  </joint>
  <link name="left_ankle_roll">
    <visual>
      <origin xyz="0 0 0" rpy="0 0 0"/>
      <geometry>
        <sphere radius="0.020"/>
      </geometry>
      <material name="orange">
        <color rgba="0.8 0.4 0.1 1.0"/>
      </material>
    </visual>
    <inertial>
      <origin xyz="0.000000 0.000000 0.000000" rpy="0 0 0"/>
      <mass value="0.35"/>
      <inertia ixx="0.00005600" iyy="0.00005600" izz="0.00005600" ixy="0.00000000" ixz="0.00000000" iyz="0.00000000"/>
    </inertial>
  </link>
  <joint name="left_ankle_roll_joint" type="revolute">
    <parent link="left_ankle"/>
    <child link="left_ankle_roll"/>
    <origin xyz="0 0 0" rpy="0 0 0"/>
    <axis xyz="1 0 0"/>
    <limit lower="-0.2617993877991494" upper="0.2617993877991494" effort="11.2" velocity="19.6"/>
  </joint>
  <link name="left_foot">
    <visual>
      <origin xyz="0 0 0" rpy="0 0 0"/>
      <geometry>
        <box size="0.15 0.08 0.04"/>
      </geometry>
      <material name="black">
        <color rgba="0.1 0.1 0.1 1.0"/>
      </material>
    </visual>
    <inertial>
      <origin xyz="0.000000 0.000000 0.000000" rpy="0 0 0"/>
      <mass value="0.15"/>
      <inertia ixx="0.00010000" iyy="0.00030125" izz="0.00036125" ixy="0.00000000" ixz="0.00000000" iyz="0.00000000"/>
    </inertial>
  </link>
  <joint name="left_foot_joint" type="fixed">
    <parent link="left_ankle_roll"/>
    <child link="left_foot"/>
    <origin xyz="0.05 0 -0.08" rpy="0 0 0"/>
  </joint>
  <link name="right_hip_yaw_link">
    <visual>
      <origin xyz="0 0 0" rpy="0 0 0"/>
      <geometry>
        <sphere radius="0.03"/>
      </geometry>
      <material name="orange">
        <color rgba="0.8 0.4 0.1 1.0"/>
      </material>
    </visual>
    <inertial>
      <origin xyz="0.000000 0.000000 0.000000" rpy="0 0 0"/>
      <mass value="0.5"/>
      <inertia ixx="0.00018000" iyy="0.00018000" izz="0.00018000" ixy="0.00000000" ixz="0.00000000" iyz="0.00000000"/>
    </inertial>
  </link>
  <joint name="right_hip_yaw_joint" type="revolute">
    <parent link="pelvis"/>
    <child link="right_hip_yaw_link"/>
    <origin xyz="0 -0.0875 0" rpy="0 0 0"/>
    <axis xyz="0 0 1"/>
    <limit lower="-0.5235987755982988" upper="0.5235987755982988" effort="11.2" velocity="19.6"/>
  </joint>
  <link name="right_hip_roll_link">
    <visual>
      <origin xyz="0 0 0" rpy="0 0 0"/>
      <geometry>
        <sphere radius="0.03"/>
      </geometry>
      <material name="orange">
        <color rgba="0.8 0.4 0.1 1.0"/>
      </material>
    </visual>
    <inertial>
      <origin xyz="0.000000 0.000000 0.000000" rpy="0 0 0"/>
      <mass value="0.3"/>
      <inertia ixx="0.00010800" iyy="0.00010800" izz="0.00010800" ixy="0.00000000" ixz="0.00000000" iyz="0.00000000"/>
    </inertial>
  </link>
  <joint name="right_hip_roll_joint" type="revolute">
    <parent link="right_hip_yaw_link"/>
    <child link="right_hip_roll_link"/>
    <origin xyz="0 0 0" rpy="0 0 0"/>
    <axis xyz="1 0 0"/>
    <limit lower="-0.5235987755982988" upper="0.5235987755982988" effort="11.2" velocity="19.6"/>
  </joint>
  <link name="right_thigh">
    <visual>
      <origin xyz="0 0 -0.15" rpy="0 0 0"/>
      <geometry>
        <cylinder radius="0.040" length="0.3"/>
      </geometry>
      <material name="blue">
        <color rgba="0.2 0.2 0.8 1.0"/>
      </material>
    </visual>
    <inertial>
      <origin xyz="0.000000 0.000000 -0.150000" rpy="0 0 0"/>
      <mass value="0.9"/>
      <inertia ixx="0.00711000" iyy="0.00711000" izz="0.00072000" ixy="0.00000000" ixz="0.00000000" iyz="0.00000000"/>
    </inertial>
  </link>
  <joint name="right_hip_pitch_joint" type="revolute">
    <parent link="right_hip_roll_link"/>
    <child link="right_thigh"/>
    <origin xyz="0 0 0" rpy="0 0 0"/>
    <axis xyz="0 1 0"/>
    <limit lower="-0.5235987755982988" upper="1.9198621771937625" effort="11.2" velocity="19.6"/>
  </joint>
  <link name="right_shin">
    <visual>
      <origin xyz="0 0 -0.15" rpy="0 0 0"/>
      <geometry>
        <cylinder radius="0.035" length="0.3"/>
      </geometry>
      <material name="blue">
        <color rgba="0.2 0.2 0.8 1.0"/>
      </material>
    </visual>
    <inertial>
      <origin xyz="0.000000 0.000000 -0.150000" rpy="0 0 0"/>
      <mass value="0.7"/>
      <inertia ixx="0.00546437" iyy="0.00546437" izz="0.00042875" ixy="0.00000000" ixz="0.00000000" iyz="0.00000000"/>
    </inertial>
  </link>
  <joint name="right_knee_pitch_joint" type="revolute">
    <parent link="right_thigh"/>
    <child link="right_shin"/>
    <origin xyz="0 0 -0.3" rpy="0 0 0"/>
    <axis xyz="0 1 0"/>
    <limit lower="0.0" upper="2.443460952792061" effort="11.2" velocity="19.6"/>
  </joint>
  <link name="right_ankle">
    <visual>
      <origin xyz="0 0 0" rpy="0 0 0"/>
      <geometry>
        <sphere radius="0.025"/>
      </geometry>
      <material name="orange">
        <color rgba="0.8 0.4 0.1 1.0"/>
      </material>
    </visual>
    <inertial>
      <origin xyz="0.000000 0.000000 0.000000" rpy="0 0 0"/>
      <mass value="0.35"/>
      <inertia ixx="0.00008750" iyy="0.00008750" izz="0.00008750" ixy="0.00000000" ixz="0.00000000" iyz="0.00000000"/>
    </inertial>
  </link>
  <joint name="right_ankle_pitch_joint" type="revolute">
    <parent link="right_shin"/>
    <child link="right_ankle"/>
    <origin xyz="0 0 -0.3" rpy="0 0 0"/>
    <axis xyz="0 1 0"/>
    <limit lower="-0.5235987755982988" upper="0.5235987755982988" effort="11.2" velocity="19.6"/>
  </joint>
  <link name="right_ankle_roll">
    <visual>
      <origin xyz="0 0 0" rpy="0 0 0"/>
      <geometry>
        <sphere radius="0.020"/>
      </geometry>
      <material name="orange">
        <color rgba="0.8 0.4 0.1 1.0"/>
      </material>
    </visual>
    <inertial>
      <origin xyz="0.000000 0.000000 0.000000" rpy="0 0 0"/>
      <mass value="0.35"/>
      <inertia ixx="0.00005600" iyy="0.00005600" izz="0.00005600" ixy="0.00000000" ixz="0.00000000" iyz="0.00000000"/>
    </inertial>
  </link>
  <joint name="right_ankle_roll_joint" type="revolute">
    <parent link="right_ankle"/>
    <child link="right_ankle_roll"/>
    <origin xyz="0 0 0" rpy="0 0 0"/>
    <axis xyz="1 0 0"/>
    <limit lower="-0.2617993877991494" upper="0.2617993877991494" effort="11.2" velocity="19.6"/>
  </joint>
  <link name="right_foot">
    <visual>
      <origin xyz="0 0 0" rpy="0 0 0"/>
      <geometry>
        <box size="0.15 0.08 0.04"/>
      </geometry>
      <material name="black">
        <color rgba="0.1 0.1 0.1 1.0"/>
      </material>
    </visual>
    <inertial>
      <origin xyz="0.000000 0.000000 0.000000" rpy="0 0 0"/>
      <mass value="0.15"/>
      <inertia ixx="0.00010000" iyy="0.00030125" izz="0.00036125" ixy="0.00000000" ixz="0.00000000" iyz="0.00000000"/>
    </inertial>
  </link>
  <joint name="right_foot_joint" type="fixed">
    <parent link="right_ankle_roll"/>
    <child link="right_foot"/>
    <origin xyz="0.05 0 -0.08" rpy="0 0 0"/>
  </joint>
</robot>
