jacob-rn-wallace/megadroid/design/actuation.yaml

# Megadroid authoritative actuation parameters
# This file is the single source of truth for motor selection, drivetrain
# reduction, and the per-joint output torque envelope.
# Do not duplicate values from this file in markdown documents.

meta:
  scope: "MVS actuation and drivetrain"
  notes: >
    Populated 2026-09-10. Before this, motor_model/motor_voltage/
    motor_count_mvs were hardcoded as Python literals in
    tools/rehydrate_spec.py and the per-joint torque envelope did not exist
    anywhere -- generate_mjcf.py emitted position actuators with no
    forcerange, so every P3 simulation result to date described a robot
    with unbounded joint torque. Changes to motor type or control mode
    require SPEC.md revision (see SPEC.md Section 15, Change Control).

motor:
  model: "775 brushed DC motors"
  voltage_nominal_v: 24
  count_mvs: 15                # 13 before the 2026-10-27 hip_yaw revision (legs 5 -> 6 DOF)
  stall_torque_nm: 0.20        # PLACEHOLDER -- representative 775-class figure at
                                # 24V, NOT a datasheet value for a selected part.
                                # 775 motors vary widely between vendors. Must be
                                # replaced with a measured or datasheet figure once
                                # a specific motor is selected (P6).
  no_load_speed_rpm: 15000     # PLACEHOLDER -- same caveat as stall_torque_nm.
  rationale: >
    Chosen for cost and availability rather than performance: the 775 is a
    commodity brushed motor, which is what makes the hobbyist cost target
    reachable. High gear reduction (below) converts its low output torque
    into usable joint torque at the expense of joint speed.

drivetrain:
  gearbox:
    class: "20:1 planetary"
    ratio: 20
    notes: >
      Single standardized gearbox class reused across all actuated joints
      (SPEC.md Section 6.2 -- no joint uses a bespoke gearbox).
  belt_stage:
    provides_reduction: true
    ratio: 4
    applies_to: "all actuated joints"
    notes: >
      SET 2026-09-10, replacing the earlier 1:1 placeholder. 4:1 on every
      actuated joint, giving 80:1 total. Two measurements bound this:

      TORQUE FLOOR. With the previous 20:1 (2.8 N-m/joint), the validated
      walking gait clipped its torque limit on 28.1% of samples and fell
      (77.59deg). Sweeping the ratio in simulation, 3x (60:1) is the first
      value that walks -- 6.32deg peak tilt, matching the unlimited-torque
      baseline -- and 4x leaves margin for the motor's torque-speed droop
      (0.4% of samples short vs 1.8% at 3x).

      CRITICALLY, THE BELT MUST INCLUDE THE ANKLES. BOM.csv previously
      listed secondary belt reduction on six joints only (hip_pitch,
      hip_roll, knee_pitch). Applied to that scope the gait NEVER walks at
      any ratio tested up to 6x: raising hip and knee simply promotes
      ankle_pitch to the binding joint (p95 demand 8.38 N-m). HUBO KHR-3
      agrees -- it puts a 2:1 pulley-belt on both ankle roll and ankle
      pitch, on top of a 100:1 harmonic drive.

      SPEED CEILING. Human motion-capture regression (CMU database, see
      reference-material/motion-capture-cmu) gives knee omega_95 = 11.0
      rad/s per leg-length/s of walking speed. At matched normalised speed
      this predicted our gait's knee omega_95 within 2% of the simulated
      value, so it transfers. It caps the knee at ~123:1 for HUBO-speed
      walking and ~74:1 for fast human walking. 80:1 sits inside the first
      and just outside the second.
    scope_limitation: >
      THIS RATIO IS SCOPED TO THE GAIT THAT CURRENTLY EXISTS, which walks at
      0.48 km/h. It is NOT sufficient for ASIMO/HUBO-class walking speed
      (1.25 km/h), and that is a known gap rather than an oversight.
      Torque demand at 1.25 km/h could not be measured: the controller only
      walks at 0.36-0.48 km/h, and three separate attempts to measure beyond
      it failed (slower cadence detunes the controller into falling;
      inverse dynamics on the planned trajectory disagreed with the forward
      simulation by 2x; longer steps fall above 0.10 m). Scaling arguments
      put the requirement at 1.25 km/h somewhere in 143-357:1, which starts
      ABOVE the 123:1 knee speed ceiling -- meaning a single 775 per joint
      may not close at that speed regardless of ratio. HUBO's answer to the
      same collision was two 150W motors on the knee at 120:1, not more
      reduction. Revisit this block when a controller exists that walks
      faster than 0.48 km/h.
    per_joint_group_note: >
      A uniform 4:1 is an interim simplification. The eventual structure
      should be per-joint, scaled INVERSELY to each joint's speed demand,
      because the knee is speed-limited and the hip is torque-limited.
      Computed ceilings at HUBO speed: knee ~123:1, hip ~238:1. HUBO KHR-3's
      own leg confirms the pattern almost exactly -- knee 120:1, hip
      288-300:1, ankle 200:1.
  efficiency: 0.70             # PLACEHOLDER -- combined gearbox + belt losses.
                                # Planetary gearsets of this class are commonly
                                # 0.6-0.8; measure on the real drivetrain (P6).
  total_reduction: 80          # gearbox.ratio * belt_stage.ratio = 20 * 4

output:
  peak_joint_torque_nm: 11.2   # DERIVED: motor.stall_torque_nm * total_reduction
                                # * efficiency = 0.20 * 80 * 0.70 = 11.2
  max_joint_speed_rad_s: 19.6  # DERIVED: no_load_speed_rpm / total_reduction,
                                # converted -- 15000/80 = 187.5 rpm = 19.6 rad/s.
                                # Recorded for reference; not enforced in
                                # simulation (see modeling_limitations).
                                # For scale: measured knee p95 speed in the
                                # current gait is 2.4 rad/s, and the human-
                                # mocap prediction for HUBO-speed walking is
                                # 6.4 rad/s -- so speed is not binding at the
                                # gait speeds reachable today.
  uniform_across_joints: true
  uniform_is_an_interim_simplification: >
    A single envelope is applied to every joint. See
    drivetrain.belt_stage.per_joint_group_note: the right structure is
    per-joint ratios scaled inversely to speed demand, which is what HUBO
    KHR-3 does. Uniform 80:1 is recorded because it is what simulation
    actually validated for the current gait, not because it is optimal.
  notes: >
    A single envelope applies to every actuated joint because a single motor
    and a single gearbox class are used throughout. For scale: the measured
    static standing hold (tools/sim_static_pose.py, current model) is
    0.655 N-m at knee_pitch and 1.33 N-m total per leg, so this envelope
    leaves roughly 2x margin over static stance before any dynamic demand.

modeling_limitations:
  flat_torque_cap: >
    peak_joint_torque_nm is applied in simulation as a FLAT cap (MuJoCo
    actuator forcerange). A real brushed DC motor's torque falls
    approximately linearly with speed, so a flat cap is optimistic at high
    joint velocity and accurate only near stall. Modeling the true
    torque-speed curve would require a velocity-dependent actuator model.
  thermal: >
    Stall torque is an instantaneous figure. Continuous operation at this
    level would overheat a 775; no thermal or duty-cycle model exists here.
  compliance: >
    Belt stretch and gear backlash are not modeled. design/sensors.yaml's
    joint-mounted encoder policy exists specifically because these are
    expected to be significant.

estimate_ranges:
  # RANGED PLACEHOLDERS. Convention (2026-10-18): where a value above is an
  # unmeasured estimate, the plausible low/high bounds live here with their
  # basis. The scalar above stays the NOMINAL used by every tool; midpoints
  # are derived by tools/sweep_estimates.py, never stored (one source of truth).
  # The point is not to pick a better single number -- results in this project
  # are knife-edge sensitive, so a lone midpoint says little about the rest of
  # the range. The sweep tool runs the P3 battery across these bounds to
  # separate conclusions that are ROBUST to the uncertainty from the ones that
  # FLIP inside it. Only the latter justify physical measurement (P4 rig).
  # A range is an estimate, not a measurement: replace it when the rig delivers.
  motor.stall_torque_nm:
    low: 0.31
    high: 0.84
    basis: >
      Vendor stall torque at 24V across found 775-class variants: 0.31 N-m
      (NFP-RC-775SHP, 3166 g-cm, 3800 rpm), 0.72 N-m (RS775SM-4445-F, 8300 rpm,
      24.5 A stall), 0.84 N-m (119.43 oz-in, 12600 rpm, 59 A stall). The current
      nominal (0.20) sits BELOW this whole range, i.e. it is an implicit derate.
      Datasheet stall is not usable peak: 25-60 A stall current exceeds what the
      motor driver or the shared DC/DC (BOM) can deliver on 15 joints at once,
      and is thermally instantaneous. Usable fraction is a separate unknown.
  motor.no_load_speed_rpm:
    low: 3800
    high: 12600
    basis: >
      Same variants as stall_torque_nm (3800 / 8300 / 12600 rpm). The nominal
      (15000) sits ABOVE the range. NOT enforced in simulation, so sweeping it
      has no effect on any P3 result until a velocity-dependent actuator model
      exists (see modeling_limitations.flat_torque_cap). Stall torque and
      no-load speed are paired per motor model, not independent.
  drivetrain.efficiency:
    low: 0.68
    high: 0.92
    basis: >
      Low = 0.72 (hobby 42mm two-stage planetary gearmotor, vendor-listed) x 0.95
      (synchronous belt floor). High = 0.94 (two stage-pair planetary, 0.97 each)
      x 0.98 (HTD typical). Belt figures are general synchronous-drive values
      (95-99%), not a datasheet for this belt.
