jacob-rn-wallace/megadroid/(commit log)

2026-01-17 # Megadroid **Megadroid** is an open-hardware humanoid robot project aimed at developing a **Hubo/ASIMO–class bipedal platform** that can be built, studied, and iterated on by advanced hobbyists and 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
2026-01-17 Add CERN-OHL-S v2 license for hardware designs
    This commit adds the CERN Open Hardware License v2 – Strongly Reciprocal
    (CERN-OHL-S) as LICENSE-HARDWARE.txt.
    This license governs all hardware designs, mechanical documentation, and
    bill-of-materials files in the repository, complementing the Apache 2.0
    license used for software and firmware. The CERN-OHL-S license ensures that
    hardware derivatives of Megadroid remain open and that improvements to the
    physical design are shared back with the community.
    The license text is included verbatim from the official CERN distribution.
2026-01-17 Add initial .gitignore for OS, build, and CAD artifacts
2026-01-17 Add authoritative CSV bill of materials aligned with MVS spec
    [BOM.csv]
2026-01-17 Switch BOM to CSV as authoritative bill of materials
    Updates the project to use a single authoritative BOM.csv file instead of an Excel-based BOM.
    CSV is chosen to improve transparency, version control friendliness, and machine readability, and to better support automated auditing and editing. The README is updated accordingly to reflect the new BOM format in the repository structure.
    Spreadsheet formats may still be generated as derived artifacts, but BOM.csv is now the canonical source of truth for cost and part tracking.
2026-01-18 Align MVS leg architecture with modular lower-leg design and lock mechanical standards
2026-01-19 Fix MVS DOF checker to include torso joints correctly
2026-01-19 Add torso joints to joint model and validate full MVS DOF count
2026-01-19 SPEC: auto-generate actuated DOF section from joints.yaml
2026-01-24 Fix README structure formatting and add BOM metadata
    [BOM.csv]
2026-01-24 Rehydrate README with current top level repository structure
2026-01-26 Fix DOF validator to count per-leg joint replication for MVS
2026-01-29 Process: re-slice roadmap into student-scale milestones and formalize dual-track development model
2026-03-08 Fix: update geometry validator for refactored structure
    Validator was checking obsolete paths from earlier geometry.yaml
    structure. Updated REQUIRED_PATHS to match current organization:
    - anthropometrics.*
    - leg_structure.twin_rail.*
    - joints.shafting.*
    - end_of_limb_sensing.ft_sensor.*
    Validated against current design/geometry.yaml changes.
2026-03-08 Design: clarify lower-leg module and F/T sensor mounting
    Enhanced geometry.yaml with explicit structural definitions:
    Lower-leg module:
    - Explicitly defined to include distal termination bulkhead
    - Clarified modular boundaries (knee interface → F/T mounting face)
    - Documented MVS vs future ankle upgrade compatibility
    F/T sensor:
    - Mounting location: distal_face_of_lower_leg_module
    - Load path requirement: axial only, no bending moments
    - Explicit notes: mounted to distal bulkhead, proximal to foot
    Parameter annotations:
    - Added STRUCTURAL markers for frozen load-path dimensions
    - Added NOMINAL_MVS markers for MVS-valid but evolvable values
    - Added GEOMETRY FREEZE STATUS header documenti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
2026-03-08 Docs: enhance MECH template with explicit structural stack
    Updated MECH.md.j2 to mirror geometry.yaml precision:
    Section 4.3 (Lower-Leg Module):
    - Added structural stack enumeration (knee → rails → bulkhead → F/T → foot)
    - Clarified distal bulkhead is part of the module
    - Made modular boundary explicit
    Section 5.4 (Module Interface):
    - Defined structural boundaries (proximal/distal)
    - Listed upgrade compatibility preservation
    - Clarified MVS vs future configurations
    Section 6 (F/T Sensor):
    - Stated mounting: 'directly to distal termination bulkhead'
    - Clarified position in structural stack
    - Made geometry.yaml authority explicit
    Language now precisely matches authoritative defini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
2026-03-08 Docs: rehydrate MECH from enhanced template
    Generated from templates/MECH.md.j2 using rehydrate_mech.py
    Reflects clarified lower-leg module definition and F/T sensor
    mounting language from design/geometry.yaml and updated template.
    Last rehydrated: 2026-03-08
2026-03-08 Improve rehydration check to only validate changed dependencies
    Enhanced workflow to detect which source files changed and only
    rehydrate derived docs that depend on those sources.
    Benefits:
    - No timestamp churn for unrelated documents
    - Faster CI execution
    - Clearer git history
    - Proper separation of concerns
    Dependency tracking:
    - SPEC.md: joints.yaml, geometry.yaml, SPEC.md.j2
    - MECH.md: geometry.yaml, joints.yaml, MECH.md.j2
    - README.md: rehydrate script, .meta.yaml files
2026-03-12 Design: define kinematic conventions and nominal standing pose
    Added design/kinematics.yaml:
    - Z-up right-hand coordinate system (robotics standard)
    - Body-fixed joint axes (compatible with ROS/URDF)
    - Base frame at pelvis center
    - Standard humanoid rotation sign conventions
    Enhanced design/joints.yaml:
    - Added nominal_stand_deg to all actuated joints
    - Nominal pose: upright with 12° knee flexion
    - Hip angles: 0° (vertical legs)
    - Torso angles: 0° (upright, facing forward)
    This completes kinematic foundation for P1 (authoritative design definition).
    Ready for kinematic modeling (P2) and simulation (P3).
2026-03-24 Docs: shorten all top-level descriptions to 64-character limit
    Updated .meta.yaml files and file headers to use concise descriptions
    (≤64 chars) for better readability in repository structure documentation.
    Directory changes:
    - design/: 'Authoritative YAML design parameters (source of truth)'
    - docs/: 'Supporting documentation and background references'
    - firmware/: 'Embedded motor/joint control for RP2350-CAN boards'
    - software/: 'High-level control, gait planning, dev tools'
    - templates/: 'Jinja templates for generating derived documentation'
    - tools/: 'Validators and rehydration scripts'
    File changes:
    - BOM.csv: 'Bill of materials and cost tracking for MVS'
    - MECH.md: 'Mechanical desi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
    [BOM.csv]
2026-03-24 P2: add URDF generation and kinematic visualization
    Stage P2 (Kinematic & Structural Validation) initial deliverables:
    New directory:
    - simulation/: Kinematic models and simulation artifacts
    Tools added:
    - tools/generate_urdf.py: Generates URDF from authoritative YAML
    - tools/verify_urdf_dimensions.py: Validates URDF dimensions vs YAML
    - tools/visualize_urdf.py: 3D matplotlib visualization (macOS-compatible)
    Generated artifacts:
    - simulation/urdf/megadroid_mvs.urdf: MVS kinematic model
    Validation results:
    - Thigh length: 0.300m (matches YAML)
    - Shin+Ankle length: 0.380m (0.300m + 0.080m, matches YAML)
    - Total leg length: 0.680m (matches YAML)
    - Stance width: ~0.300m (reasonable)
    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
    [megadroid_mvs.urdf]
2026-03-24 P2: add workspace analysis and validation
    Added tools/analyze_workspace.py to validate joint ranges and
    reachable workspace for MVS leg kinematics.
    Analysis results:
    - Nominal pose: foot at Z=0.008m (on ground) ✓
    - Forward reach: 0.34m (adequate for walking)
    - Backward reach: 0.68m (full leg extension)
    - Upward reach: 1.16m (adequate for stairs)
    - Downward reach: 0.0m (can reach ground)
    Validates:
    - Joint ranges produce smooth, collision-free workspace
    - Nominal standing pose places foot on ground
    - Anthropometrics support walking and stair climbing
    - No singularities detected in sampled configurations
    P2 validation criteria met:
    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
2026-03-24 P2: add validation summary report
    Stage P2 validation complete. All criteria met:
    ✓ Kinematic models built from authoritative YAML
    ✓ Joint ranges validated (400 configurations sampled)
    ✓ Anthropometrics confirmed (680mm leg, adequate workspace)
    ✓ Stance feasibility confirmed (foot on ground in nominal pose)
    ✓ No singularities or problematic configurations found
    Documented in docs/P2_VALIDATION.md with full results and evidence.
    Ready for Stage P3 (Simulation-First MVS Validation).
2026-04-23 Design: expand MVS scope to 11 DOF, add ankle pitch
    - ankle_pitch promoted to MVS: true, actuated: true
    - ankle_pitch joint limits set to [-30°, +30°] based on functional
    gait requirements from biomechanics literature
    - ankle_pitch nominal_stand_deg: 0, angle_reference: foot_flat
    - ankle_pitch axis added to kinematics.yaml joint_axes
    - meta.mvs_dof_total added to joints.yaml: 11
    - validate_dof_consistency.py updated to read expected DOF from
    meta.mvs_dof_total rather than hardcoded constant
    Rationale: ankle pitch is the minimum DOF required for ZMP-controlled
    walking with genuine single-support phase stability. A milestone that
    requires immediate extension upon completion is not a val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
2026-04-23 Docs: rehydrate from updated joints.yaml and kinematics.yaml
    MVS DOF count updated to 11 throughout derived documents.
2026-04-23 Docs: add PHILOSOPHY.md
    Captures project vision, design rationale, authority hierarchy, and
    cost philosophy. Static document — not auto-generated. Establishes
    the why behind decisions recorded in SPEC.md and design/*.yaml.
2026-04-23 Templates: update SPEC and MECH templates for 11-DOF MVS scope
    - SPEC.md.j2: cost target reframed to hobbyist desktop PC range
    (~$800-1500 USD); ankle pitch included in MVS; ankle roll listed
    as post-MVS exclusion; philosophy section links to PHILOSOPHY.md
    - MECH.md.j2: authority header corrected from authoritative to derived;
    leg DOF updated to four per leg; lower-leg module stack and
    descriptions updated to reflect actuated ankle pitch; authority
    section updated to reflect derived status
2026-04-24 URDF: regenerate for 11-DOF MVS; fix generator and verifier
    generate_urdf.py:
    - Ankle pitch joint inserted between shin and foot per leg
    - Hip roll and hip pitch now separate revolute joints (previously
    hip roll was silently dropped)
    - All joint axis directions read from kinematics.yaml, not hardcoded
    - All joint limits read from joints.yaml, not hardcoded
    - Hip lateral offset read from geometry.yaml twin-rail spacing
    - Torso now three proper revolute joints (pitch, roll, yaw)
    - Ankle inclusion driven by is_mvs_actuated() check — URDF follows
    YAML automatically if scope changes again
    - Fixed foot joint origin to use full ankle_to_sole_offset, not half
    verify_urdf_dimensions.py:
    - Upda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
    [megadroid_mvs.urdf]
2026-05-20 Infra: add CLAUDE.md — AI assistant context for Claude Code
2026-06-26 Infra: fix check_joints.py DOF bug; expand CLAUDE.md
    check_joints.py had EXPECTED_MVS_DOF hardcoded as 9 instead of 11,
    causing the script to always report failure against the actual MVS
    configuration. Fixed to match the authoritative value in joints.yaml.
    CLAUDE.md additions and corrections:
    - Add Licensing section (Apache 2.0 for software, CERN-OHL-S v2 for hardware)
    - Add simulation/urdf/megadroid_mvs.urdf to document hierarchy
    - Add URDF regeneration as a workflow step (generate_urdf.py + verify step)
    - Fix validation step to reference validate_all.py as primary entry point
    (was listing individual scripts; rehydrate_all.py was already the pattern)
    - Add generate_spec_dof.py to toolcha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
2026-06-26 Infra: fix CWD bugs, add preflight, close CI gap, streamline toolchain
    CWD-independence (all scripts now work from any directory):
    - validate_all.py: add REPO_ROOT, use absolute paths and cwd=REPO_ROOT in
    subprocess calls — was silently running wrong files if not in repo root
    - validate_dof_consistency.py, validate_no_geometry_literals.py,
    validate_geometry.py, check_joints.py, generate_spec_dof.py: all used
    relative paths for design/*.yaml / derived docs; converted to REPO_ROOT
    CI gap: validate_geometry.py was run by validate_all.py but absent from
    validate.yml — added it as a step so geometry checks run in CI too
    New tool tools/preflight.py: runs rehydrate → validate → git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
2026-06-26 P3: add MuJoCo simulation foundation (mass, MJCF generator, load test)
    design/mass.yaml (new):
    Authoritative mass estimates per link — 8.9 kg total. Nominal values
    based on 775 DC motor assemblies + structural framing; to be verified
    during P6 physical build.
    tools/generate_urdf.py (updated):
    Now reads mass.yaml and emits <inertial> elements for every link.
    Adds box_inertia/cylinder_inertia/sphere_inertia helpers. URDF is now
    dynamics-capable and loads cleanly in MuJoCo. Signature updated:
    create_urdf(..., mass_data).
    tools/generate_mjcf.py (new):
    Generates simulation/mujoco/megadroid_mvs.xml from all four design
    YAML files. Produces a complete MuJoCo scene: floating pe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
    [megadroid_mvs.urdf, megadroid_mvs.xml]
2026-06-26 P3: fix sim_standing.py initialization; fix foot geom contact plane
    sim_standing.py:
    Removed erroneous freejoint z-override that set pelvis to z=0.
    mj_resetData already initializes freejoint from MJCF body pos (0.68m).
    generate_mjcf.py / megadroid_mvs.xml:
    Foot geom pos changed from '0 0 0' to '0 0 0.020' so the bottom face
    of the foot box sits at the foot body origin (the sole contact point)
    rather than 20mm below it. Previously the foot started underground,
    causing MuJoCo to fire a large contact impulse on step 1.
    Standing test still fails: joint position control alone cannot balance a
    floating-base biped — the pelvis tips freely. Next step is either a
    fixed-base static pos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
    [megadroid_mvs.xml]
2026-09-07 Fix pelvis self-collision with legs/torso in generated MJCF
    The pelvis collision box (300mm wide) was far larger than the actual
    100mm hip-rail spacing, so it overlapped the thigh cylinders; the
    torso_pitch/roll/torso links are stacked at the same point by design
    and their non-adjacent pairs overlapped too. MuJoCo only auto-excludes
    direct parent/child pairs, so these grandparent-grandchild overlaps
    injected large spurious contact forces into any load/torque
    measurement. Shrink the pelvis box to fit within the hip spacing and
    add explicit <contact><exclude> pairs for the remaining structurally-
    adjacent-but-not-parent-child overlaps.
    C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
    [megadroid_mvs.xml]
2026-09-07 P3: add fixed-base static pose validation test
    Position control alone can't balance a floating-base biped (nothing
    corrects pelvis tip-over), so sim_standing.py never passed. Replace it
    with sim_static_pose.py: weld the pelvis to the world (like a
    test-stand bolt), hold the nominal standing pose, and validate the
    weld's reaction force converges to the robot's exact computed weight
    (87.31 N, 0% error) with joint torques symmetric left/right.
    Ground contact is deliberately excluded — welding the pelvis while
    feet also rest on the ground makes support statically indeterminate,
    since the weld alone could supply the vertical load. The weld and
    contact exclusions are injected into the model in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
2026-09-07 P3: add floating-base ZMP ankle-pitch balance controller
    Implements the P3 dynamic-balance deliverable from CLAUDE.md: a
    proportional ankle-pitch controller on the Zero Moment Point (ZMP),
    measured from foot contact forces, that holds the ZMP at the support
    polygon's centroid. Stable indefinitely on the unmodified floating-base
    MJCF (tested to 30s simulated, <1 deg pelvis tilt).
    Two things had to be fixed to get a working controller, both documented
    in the script:
    1. The naive nominal pose (bend only the knee) leaves the pelvis/torso
    column well forward of the foot -- a large structural lean, not a
    small perturbation, and more than an ankle-only strategy can ever
    correct. NOMINAL_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
2026-09-07 P3: add walking gait — one quasi-static step validated
    Builds on sim_zmp_balance.py's standing controller to take a step
    forward. Validates a genuine new capability standing balance alone
    can't show: shifting weight fully onto one foot, swinging the other
    leg forward, and landing without falling (478mm forward, ~35deg peak
    tilt, recovers).
    Needed one new mechanism beyond the standing controller: lateral
    (hip_roll) weight transfer, since the MVS has no ankle_roll to shift
    ZMP sideways. Rotating both hip_roll joints by the same angle, with
    both feet planted, shifts the pelvis sideways relative to the fixed
    feet (FK-solved, ~4.25deg for a full transfer). A second filtered-ZMP
    feedback loop (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
2026-09-07 P3: substantially improve walking gait step quality; find real root cause of multi-step failure
    Retunes the single validated step from ~35deg peak tilt down to ~5deg
    by fixing real bugs, not just re-sweeping gains:
    1. The swing leg was inheriting the stance leg's shifted hip_roll for
    the whole swing, landing ~30mm laterally off from its intended
    footprint every step. Fixed by tracking hip_roll per leg: the swing
    leg's ramps back to neutral during swing(), the (former) stance
    leg's during settle() -- both converge to a clean symmetric (0, 0)
    double-support pose before the next shift.
    2. Using the same hip_pitch advance magnitude for the stance leg's
    forward-drive as the sw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
2026-09-07 P3: extend walking gait to two steps; correct earlier root-cause diagnosis
    Two steps now pass (~19deg peak tilt, no fall, ~185mm total swing-foot
    progress), up from one. The fix: ANKLE_KP needs to be phase-dependent.
    Single support (swing) needs a strong, fast gain; using that same gain
    during double support (shift/settle) causes slow divergence there --
    measured directly, the plain nominal double-support pose (zero
    deviation, no gait motion) diverges to ~11deg of tilt over 1.5s at
    kp=4, but holds to ~1deg at kp=1 (the gain sim_zmp_balance.py's
    standing controller independently validated). Split into
    ANKLE_KP_DOUBLE and ANKLE_KP_SINGLE. Also fixed shift() to target the
    double-support centroi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
2026-09-08 P3: rearchitect walking gait for smoothness — LIPM/DCM trajectory generator
    Supersedes sim_walk_gait.py's reactive phase-based state machine, whose
    validated 3 steps look like stumbling on video (pelvis nets ~213mm
    backward even as the swing foot lands forward). Replaces it with a real
    model-based generator: footstep plan -> piecewise ZMP reference -> CoM
    trajectory via the DCM/Capture Point method (RK4-integrated) -> per-leg
    inverse kinematics -> MuJoCo drive loop with a ZMP feedback trim, the
    standard technique behind ASIMO/HRP/Valkyrie-generation walking
    generators.
    Validated: 3 steps, 16.9deg peak tilt (vs. the old gait's ~20deg) and,
    for the first time, NET-FORWARD pelvis motion (+35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
2026-09-08 P3: replace ad-hoc ZMP trim with real DCM tracking control — 9 steps validated
    The 3-works-4-fails wall documented in the previous commit turned out to
    be a fundamental control-architecture gap, not a tuning problem, per the
    user's explicit request to check the literature before continuing to
    tune blindly. Confirmed via direct research (Zhu & Thomas 2023 on the
    Capture-Point-based FORREST pattern generator, cross-referenced with
    Kajita et al.'s 2003 ZMP preview control lineage): the DCM's own
    dynamics are open-loop unstable by construction, and the previous ad-hoc
    ZMP-error hip_roll/ankle_pitch trim never measured CoM velocity, the
    missing half of the standard fix.
    Replaced it with real D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
2026-09-08 P3: filter the DCM measurement — 15 steps validated (up from 9)
    The step-10 wall found after adding DCM tracking control turned out to
    be a second instance of the same failure category, not a new one: a
    slowly growing lateral oscillation crossing an instability threshold at
    a fixed elapsed time. Diagnosed by testing n_steps=10/12/15/20 and
    finding the >15deg tilt onset at an identical t=6.93s regardless of
    total plan length, which rules out "approaching the plan's own end" and
    points at something intrinsic to the control loop instead.
    Root cause: the DCM tracking law is stable given a clean measurement,
    but the raw per-step capture point computed from mj_subtreeVel is noisy,
    slowly pumpin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
2026-09-08 P3: smooth out per-step rocking/bobbing — raise ds_fraction to 0.4
    The 15-step gait was fully stable but the user reported it still looked
    visibly "stumbly" on video. Traced it to a real, measured effect, not a
    rendering artifact: the walk had a genuine ~6.9deg peak-tilt rocking and
    ~14mm vertical pelvis bob every single step. Confirmed this wasn't a
    K_DCM/DCM_FILTER_ALPHA tuning gap (both already near their local-optimum
    values via direct sweep); the fix was a gait timing change instead.
    Raised plan_footsteps' ds_fraction default from 0.3 to 0.4 (more
    double-support time, proportionally less single-support time per step),
    which nearly halves both the rocking (6.9 -> 5.5deg) and the bob
    (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
2026-09-08 P3: tighten DCM correction clamp — recovers 15-step range at the smoother gait timing
    The ds_fraction=0.4 smoothness fix (previous commit) cost 2 steps of
    validated range (15 -> 13) as an accepted tradeoff. Continuing the same
    investigation found it wasn't a hard tradeoff after all: the step-13/14+
    wall showed the identical diagnostic signature as the earlier step-9/10
    wall (a >15deg tilt onset at a fixed elapsed time -- here ~9.6s --
    regardless of total plan length), suggesting the same slow-resonance
    mechanism, just not fully suppressed by the existing DCM filter alone
    this time.
    Swept MAX_DCM_CORRECTION_M (the correction's safety clamp) directly
    against it: tightening from 0.08 to 0.04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
2026-09-08 Context: trim derivable content and lazy-load P3 log from CLAUDE.md
    Root CLAUDE.md loaded ~33k chars every session regardless of task. Moved
    the P3 simulation debugging log (the bulk of the file) to tools/CLAUDE.md,
    which only loads when a session touches files under tools/; left a
    pointer in its place. Also cut the tools/ file listing and repository
    directory tree, both fully derivable via ls/find, keeping the
    non-derivable Dependencies table (no requirements.txt exists elsewhere).
    Claude-Session: https://claude.ai/code/session_01AHR3z3mgUGSG2NVo8EEy6h
2026-09-08 Design: consolidate sensing strategy into design/sensors.yaml
    The F/T sensor's spec lived undisclosed inside geometry.yaml (a file
    describing itself as "structural constants"), and neither it nor the
    joint-encoder policy were actually sourced from YAML in the rendered
    docs — both were hardcoded prose in the Jinja templates, silently
    bypassing the project's own single-source-of-truth rule. SPEC.md even
    split the F/T sensor (Sec 5.1) from the Sensors section (Sec 7).
    New design/sensors.yaml is now the single authoritative home for all
    sensing strategy: joint position sensing, motor-sensing exclusions, and
    the end-of-limb 6-DOF F/T sensor form factor/mounting/load-path spec
    (moved out of geo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
2026-09-08 Docs: rehydrate SPEC.md and MECH.md from design/sensors.yaml
    Reflects the previous commit's sensing-strategy reorg: SPEC.md's Sensors
    section (7.1-7.3) and MECH.md's joint/F-T-sensor sections now render
    live values from design/sensors.yaml instead of static template prose.
    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
2026-09-08 Context: add gitignored reference-material/ for local paper research
    Mirrors the pattern already used in the soynut project: a local-only
    folder for research/provenance material (curated PDFs copied from the
    personal paper library) that nothing in the build reads and that must
    never reach the public repo, since these are copyrighted third-party
    papers. Documented in tools/CLAUDE.md so future sessions know it exists
    and what's in it, instead of only discovering it by accident.
    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
2026-09-08 Context: add priority-reading triage to tools/CLAUDE.md reference index
    Triaged all 82 papers in reference-material/ (three parallel batches)
    against this project's actual open problems: the receding-horizon
    growing-discontinuity wall, the HUBO-style local-feedback architecture
    under consideration, the unbuilt F/T sensor physical design, and the
    unstarted stair-climbing MVS goal. ~20 papers came back worth reading;
    persisting just those here so the triage doesn't have to be redone next
    session.
    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
2026-09-08 Design: add passive spring-centered ankle_roll, adopt flat sole plate
    A spherical foot has no lever arm regardless of orientation, so the
    existing actuated ankle_pitch was mechanically inert against the
    "ball foot" design SPEC.md described — a real physical inconsistency,
    not just stale wording. Confirmed against HUBO's own paper (this
    project's stated existence-proof): both ankle axes sit proximal to
    the F/T sensor, which mounts directly atop the foot.
    ankle_roll goes from an unused stub (variants.MVS: false, limits_deg:
    null) to installed-but-passive: variants.MVS: true, actuated: false,
    with a new passive_type: spring_centered field (first passive joint
    in this schema) and a nominal sp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
2026-09-08 Generators: emit ankle_roll in MJCF/URDF, fix SPEC.md DOF undercount
    generate_mjcf.py and generate_urdf.py now build the ankle_roll
    body/joint (spring stiffness/springref attributes in MJCF), co-located
    with ankle_pitch since no physical stack height has been dimensioned
    yet. generate_urdf.py's is_mvs_actuated() conflated "installed" with
    "actuated" — its only call site — replaced with is_installed(), which
    gates link/joint existence on variants.MVS alone since URDF has no
    concept of actuation at all. verify_urdf_dimensions.py now sums all
    ankle-stack joint offsets explicitly instead of assuming ankle_pitch
    is exactly one hop from the foot joint.
    Unrelated bug found and fixed in the sam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
2026-09-08 Docs: rehydrate SPEC/MECH/README, regenerate URDF/MJCF for ankle_roll
    Mechanical output of the previous two commits: SPEC.md now correctly
    shows 11 actuated DOF (was 9) with Ankle Pitch listed, describes the
    flat sole plate and passive ankle_roll instead of the never-actually-
    simulated "ball foot". MECH.md's structural stack, DOF count, and F/T
    sensor section updated to match. URDF and MJCF regenerated — 17 bodies
    (was 15), still 11 actuators, dimensions still match design/geometry.yaml
    exactly.
    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
    [megadroid_mvs.urdf, megadroid_mvs.xml]
2026-09-08 Context: update BOM/CLAUDE.md counts and P3 docstrings for ankle_roll
    BOM.csv is hand-maintained (labeled authority: derived but no
    rehydration script exists for it anywhere in tools/ — a pre-existing
    gap, not addressed here). Its motor/gearbox counts follow the
    corrected 11 actuated DOF; encoder count goes to 13, not 11 — the new
    MECH.md Sec 5.1 policy gives ankle_roll an encoder too despite being
    passive, which the plain actuated-DOF count doesn't capture. Added a
    line for the new pivot hardware itself and reworded the foot line to
    match SPEC.md Sec 5.
    CLAUDE.md's Key Design Constants and tools/CLAUDE.md's sim_load_test.py
    body count updated to stay accurate. sim_zmp_balance.py and
    si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
    [BOM.csv]
2026-09-09 Fix: make README rehydration gitignore-aware
    The CI push after the last commit failed rehydration-check: committed
    README.md had a "reference-material/" line, but a clean checkout
    regenerates without it since that directory is gitignored and never
    gets checked out.
    Root cause: collect_entries() did a raw REPO_ROOT.iterdir(), with no
    .gitignore awareness at all — it only skipped dotfiles. Whichever
    machine last ran the rehydrator got whatever gitignored top-level
    entries happened to exist on its local disk baked into the committed
    README, while CI's clean checkout (correctly) never has them. This
    would recur for any future gitignored top-level path, not just this
    one directory — fixed ge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
2026-09-09 Design: make ankle_roll actuated (interim), not passive spring-centered
    Walking-controller regression check (never previously run) found both
    sim_walk_lipm.py and sim_walk_recede.py fall over (~90deg peak tilt) with
    a passive spring-centered ankle_roll at any physically plausible spring
    stiffness: neither controller has any lateral (roll-axis) feedback, so an
    uncontrolled passive DOF near the ankle wobbles unchecked.
    Per user direction, ankle_roll is temporarily actuated instead so a
    future incremental swap (all joints powered -> validate -> swap specific
    joints to passive springs one at a time) can proceed from a known-good
    baseline. mvs_dof_total 11 -> 13 (ankle_roll is a leg joint, +2 fo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
    [geometry.yaml, mass.yaml]
2026-09-09 Context: update templates, sim docstrings, and CLAUDE.md for ankle_roll actuation
    templates/SPEC.md.j2, templates/MECH.md.j2: describe ankle_roll as
    actuated (interim), matching design/joints.yaml; also drops a stale
    "ankle roll is post-MVS" exclusion line in SPEC.md Sec 12 that already
    contradicted the prior session's installed-but-passive state.
    tools/sim_walk_lipm.py, tools/sim_walk_recede.py: mark both files'
    previously-validated walking numbers as REGRESSED as of today, not
    fixed by ankle_roll's actuation alone -- retested cleanly after
    committing the real design change and both still fall (~87-96deg peak
    tilt). Recompute the CoM-height selftest constants a second time
    (z_c/Tc shifted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
2026-09-09 Docs: rehydrate SPEC/MECH, update root CLAUDE.md and BOM for ankle_roll
    SPEC.md/MECH.md rehydrated from the updated templates and joints.yaml
    (13 actuated DOF). Root CLAUDE.md's Key Design Constants updated to
    match. BOM.csv: motor/gearbox counts 11 -> 13, encoder count unchanged
    at 13 (already counted the passive ankle_roll's encoder; now it's
    counted as one of 13 actuated joints instead), and the now-inapplicable
    "Passive Spring-Centered Ankle Roll Pivot" line item removed.
    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
    [BOM.csv]
2026-09-09 URDF/MJCF: regenerate for ankle_roll actuation
    ankle_roll drops its <joint stiffness>/<joint springref> attributes
    (no longer passive) and gains a position actuator, generated
    automatically by the existing actuated+MVS filter in generate_mjcf.py
    -- no generator code changes were needed. Verified via
    verify_urdf_dimensions.py (leg lengths unchanged, ankle_roll's z-offset
    still zero) and sim_load_test.py (17 bodies, 13 actuators, 9.60kg).
    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
    [megadroid_mvs.urdf, megadroid_mvs.xml]
2026-09-09 P3: add local lateral ZMP feedback (ankle_roll); fix real sagittal regression
    Implements the local balancing layer HUBO's own architecture uses
    (Heo/Lee/Oh 2012: offline pattern + damping controller + ZMP compensator,
    not a monolith) and the position-control-compatible admittance approach
    from Li/Zhou/Tsagarakis/Caldwell 2016 -- both read this session to ground
    the design. sim_zmp_balance.py's compute_zmp() already computed both x
    and y ZMP from contact points; y was silently unused until now. New
    lateral_zmp_correction() in sim_walk_lipm.py reuses it plus the existing
    zmp_reference() planned target, applied only to planted feet's ankle_roll,
    with a new _selftest_stage5c validating its sign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
2026-09-09 P3: model F/T sensor in sim, add admittance control; big nominal-walking gain, no push-robustness gain (honest result)
    Models design/sensors.yaml's per-foot 6-DOF F/T sensor in the MJCF for the
    first time (generate_mjcf.py: zero-DOF/zero-mass {s}_ft_sensor body between
    ankle_roll and foot, site on foot, force/torque sensors) and implements
    admittance control from it (ankle_roll_admittance in sim_walk_lipm.py,
    COMAN paper's rigid-actuation Ks->infinity case), replacing the
    lateral_zmp_correction layer added earlier this session. This is the real
    mechanism the project's own design commits to for local balance feedback
    (not an approximation via contact-geometry ZMP inference), and per-foot
    sens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
    [megadroid_mvs.xml]
2026-09-09 P3: implement footstep position+timing adaptation; fourth mechanism, same push-robustness wall, shipped inert with real regression avoided
    Implements capture_point_footstep_with_timing: a closed-form (no scipy
    dependency) solution to Khadiv et al.'s constrained multi-objective QP
    (position + timing + DCM offset), the one piece of the formal method
    sim_walk_recede.py's existing capture_point_footstep explicitly left out
    of scope. Verified to machine precision against its own equality
    constraints and to reduce exactly to the old position-only formula in the
    joint alpha2,alpha3->infinity limit (a real derivation subtlety: alpha3,
    not alpha2 alone, is what matters -- caught by testing the real m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
2026-09-09 Docs: document push-recovery/capturability literature synthesis
    Five local disturbance-rejection mechanisms failed this session (spring,
    ZMP compensator, F/T admittance, footstep timing, integral action), all
    hitting an identical wall on the same 5-30N push battery. Reading Honda's
    foundational balance paper suggested torso/hip angular momentum as the
    missing piece; five more papers (Koolen/Pratt capturability parts 1-2,
    Stephens & Atkeson push-recovery-by-stepping, Stephens integral control,
    Runge et al. ankle/hip biomechanics) were procured to check that
    hypothesis against the actual literature before building a sixth
    mechanism.
    Documents the resulting synthesis: four independent, converg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
2026-09-09 P3: loosen footstep Y-clamp for capture-point-lite push recovery; sagittal fixed, lateral still open (honest result)
    Sixth mechanism, but scoped as "fix the two real gaps" per the
    capturability literature synthesis rather than another ad-hoc trim:
    loosened MAX_FOOTSTEP_ADAPT_Y_M (0.01->0.03, via joint 2D grid search)
    and re-swept K_ADM and the timing clamp against the push battery
    specifically. Sagittal push recovery goes from ~0-1/5 to 4/5 forces
    surviving cleanly. Lateral remains unrecovered above 5N -- three
    independent levers (Y-clamp, K_ADM, timing clamp) were each directly
    tested against the lateral battery and none move it, ruling out further
    clamp-loosening as the fix. Full before/af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
2026-09-09 Docs: investigate lateral stance-geometry hypothesis, find the real cause (growth-factor amplification)
    b_nom_y=0 is confirmed as a real bug in two places (replan_horizon and
    the footstep-placement law both discard the ~57mm real nominal lateral
    DCM offset), but two tested fixes for it didn't move push recovery.
    Direct instrumentation found the actual cause: the footstep-adaptation
    clamp saturates almost every retarget tick on both axes even during
    undisturbed nominal walking (growth-factor noise amplification, a
    limitation already flagged in-code but not previously shown to be this
    pervasive) -- so every lever swept this session (Y clamp, K_ADM, timing
    clamp, b_nom_y) was downstream of an a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
2026-09-09 Docs: trace growth-factor amplification to a b_nom_y magnitude error; naive fix causes a new regression
    Algebraic decomposition of raw_delta_y shows the saturation isn't
    primarily noise amplification (as the previous entry framed it) -- it's
    that b_nom_y is defined relative to the wrong reference point and is off
    by roughly a full stance width. Re-derived the correct value (~43.2mm,
    grounded in a real DCM-dynamics invariant: a(t)*growth(t) is
    time-invariant for a nominal single-support trajectory) and tested it:
    first several ticks improve dramatically (125mm -> single digits), but
    a fixed constant only holds exactly at one swing-progress point, and
    residual per-tick error compounds step ove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
2026-09-09 Docs: per-swing calibrated b_nom_y (Plan Mode, approved) fails faster and worse than the fixed constant
    Implemented, compiled, tested, and reverted (not committed as code) --
    calibrating b_nom_y fresh from each swing's first retarget measurement
    was approved via Plan Mode as the fix for the b_nom_y magnitude error
    found earlier today. It fails for a clear, fundamental reason: raw_delta
    stays ~0 by tautological construction (the calibration always redefines
    "nominal" as wherever the robot currently is), which means the mechanism
    has zero restoring force toward the true ±HIP_Y stance geometry. xi_y
    diverges to -304mm within 8 swings of nominal walking with zero push
    applied -- worse and faste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
2026-09-09 Docs: b_nom_y magnitude sweep closes out the investigation -- every nonzero value is neutral-or-worse
    Swept a fixed b_nom_y = k * nominal_y across k in {0, -0.2, -0.4, -0.6,
    -0.8, -0.8636} against nominal-walk stability (n=10/18/25). Monotonic:
    larger |k| fails earlier and harder, with the current committed baseline
    (k=0, the "broken" value this whole investigation targeted) tied-or-
    better than every nonzero value tested. Diagnostic only, reverted.
    Three structurally different b_nom_y fixes plus this magnitude sweep
    have now all failed to improve on baseline. The rest of the control
    stack was tuned empirically with b_nom_y=0 already baked in, so
    correcting it in isolation makes things wors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
2026-09-09 Docs: reachability-based clamping (Plan Mode, approved) fails immediately, exactly as the plan's own risk flag predicted
    Removed MAX_FOOTSTEP_ADAPT_Y_M's delta-from-nominal clamp, relying on
    leg_ik's existing UnreachableTarget exception alone. The plan flagged
    this risk up front: UnreachableTarget only fires past 600mm of leg
    reach, but the problematic raw_delta_y values are 40-125mm -- nowhere
    near that limit. Result: nominal walking (zero push) fell by n=10,
    walking backward, confirming the clamp's real job was suppressing a
    balance-relevant bias unrelated to kinematic reachability. Diagnostic
    only, reverted, not committed as code.
    Five structurally different mechanisms against the latera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
2026-09-09 Docs: coordinated whole-stack re-tune (Plan Mode, approved) fixes nominal-walk stability but not lateral push recovery
    Jointly swept b_nom_y (3 budgeted values: -0.1, -0.2, -0.3) against
    K_DCM_RECEDE x MAX_FOOTSTEP_ADAPT_Y_M, rather than changing one term in
    isolation. Found a genuinely strong nominal-walking configuration at
    k=-0.2 (K_DCM_RECEDE=-0.77, Y_clamp=0.03: 6.32 degrees flat through
    n=30, vs the documented baseline falling at n=25) with sagittal push
    recovery preserved. But lateral push recovery is unchanged at all three
    budgeted b_nom_y values -- still only 5N survives, 10N+ always falls,
    the same ceiling every prior mechanism hit. k=-0.3 is an outright
    regression (even 5N now fal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
2026-09-09 P3: keep the nominal-walking-quality gain from the coordinated re-tune (b_nom_y=-0.2x, K_DCM_RECEDE=-0.77)
    Six mechanisms failed to fix lateral push recovery this session, but the
    coordinated re-tune's search found a real, non-regressive improvement to
    nominal walking: flat 6.32deg through n=30 (was falling at n=25), with
    sagittal push recovery preserved. User's call to keep it despite not
    solving the original lateral-recovery goal -- it's a genuine walking-
    quality win on its own. Full selftest and push-battery re-verification
    against the committed file (not just runtime overrides) confirms the
    diagnostic numbers exactly. Details in tools/CLAUDE.md.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
2026-09-09 Docs: read the 6th originally-requested paper (Kim & Oh, compliant ankle joint) -- a different problem than push recovery
    Procured via ILL and added to reference-material/humanoid-robotics/,
    closing out the original 6-paper set requested at the start of the
    push-recovery literature review. Read in full: it's about preventing
    stance-foot liftoff caused by the walking pattern's OWN fast control
    inputs (not external pushes) via mechanical sole compliance -- a
    urethane interposer between sole and ankle F/T sensor, not a
    spring-centered ankle joint. No connection found to this session's
    lateral push-recovery investigation (no external-disturbance testing in
    the paper at all), but the sole-complia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
2026-09-09 Design: keep all 13 joints actuated for the time being, defer ankle_roll's passive-reversion plan
    Prompted by a question about whether lateral push recovery is
    realistically achievable given ankle_roll's actuation was documented as
    interim. hip_roll, ankle_roll, and torso_roll are all already actuated,
    so the software investigation this session was never blocked by missing
    hardware authority. But the design's stated long-term intent (revert
    ankle_roll to passive spring-centered) would remove the dominant
    push-recovery lever per capturability theory and real hardware (M2V2,
    Sarcos Primus both keep an actuated ankle for this reason) -- so that
    plan is deferred, not committed, rather than acted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
    [geometry.yaml, mass.yaml]
2026-09-09 Docs: rehydrate SPEC/MECH for the ankle_roll design-intent update
    Templates updated to match design/joints.yaml's ankle_roll comment
    (previous commit): prose no longer frames actuation as an interim
    workaround with a committed reversion plan. Rehydrated output only,
    no numeric/DOF content changed (confirmed via diff).
    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
2026-09-09 Docs: update root CLAUDE.md design-constants summary and P3 log for the ankle_roll decision
    Same reframing as the design/*.yaml and template changes: root
    CLAUDE.md's Key Design Constants section and tools/CLAUDE.md's dated
    entry document the decision to keep all joints actuated for the time
    being and defer the ankle_roll passive-reversion plan.
    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
2026-09-09 Docs: implement and test the real CoP-repulsion law -- correctly bounded, it has zero measurable effect on the 10N lateral push
    Found ankle_roll_admittance was a torque-zeroing admittance law, not
    the capture-point-error-driven CoP-repulsion law M2V2/Sarcos Primus
    actually used (despite being cited as the target mechanism repeatedly
    this session). Implemented it for real: wired dcm_err (already computed
    for the pelvis correction) through the existing but unused tau_x_target
    parameter, scaled by measured vertical contact force.
    Unclamped, a broad sweep found apparent wins at K_IC=5/-30/-50 (first
    mechanism to recover the 10N lateral push at all) -- but a finer sweep
    showed chaotic, non-monot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
2026-09-10 P3: EMA b_nom_y + re-tuned K_ADM_RECEDE; flat nominal walk through n=45, lateral push ceiling unchanged (8th mechanism to fail)
    Path (a) (user's call): fix b_nom_y properly and re-wire CoP-repulsion,
    tested jointly. The EMA b_nom_y estimate (anchored at k=-0.2, slowly
    adapting per swing, drift-capped) is a real nominal-walking win on its
    own. Along the way, found the committed baseline itself had silently
    drifted stale since dca7009 shifted z_c/Tc again after it was tuned --
    even 5N lateral pushes, previously always-safe, were failing. Re-tuned
    K_ADM (K_DCM_RECEDE/Y_clamp confirmed already optimal) against the
    current model: K_ADM_RECEDE=5000 holds flat through n=45 where the old
    shared K_AD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
2026-09-10 P3: push-test support for run_walk + investigate d_inf-vs-empirical discrepancy; axis mismatch confirmed, receding-horizon hypothesis ruled out
    Investigated why the literature synthesis's d_inf~=89mm ankle/CoP-only
    recovery margin doesn't match this session's empirical zero-effect
    result for CoP-repulsion. Found the margin calc mixed sagittal
    parameters (foot half-length, X-clamp) into what was presented as a
    general figure -- corrected lateral value is ~48mm, about half the
    original claim, but that alone doesn't explain 10N (24mm needed)
    reliably failing.
    Added push_at/push_force/push_duration to run_walk (mirrors
    run_walk_recede's existing convention) to test whether the receding
    horizon'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
2026-09-10 P3: actuate ankle_roll in sim_walk_gait.py (was stale-assumed passive); real fix, but 3-step regression itself resists six tested parameters
    sim_walk_gait.py's balance strategy was written when ankle_roll was a
    passive, spring-centered joint -- it became fully actuated (2026-09-09
    decision) but this file never added a controller for it, leaving it
    rigid at 0deg via generate_mjcf.py's stiff position servo. Wired in
    the already-validated ankle_roll_admittance (reused from
    sim_walk_lipm.py, not reimplemented) with proper F/T sensor plumbing
    and a missing mj_forward/mj_rnePostConstraint seed call.
    Root-caused the file's own 3-step regression (found via this session's
    P3 milestone spot-check) as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
2026-09-10 Docs: P3 milestone audit -- 2 of 5 documented quick-reference commands are broken, and preflight/CI cannot catch it
    Ran every P3 validation script exactly as the root CLAUDE.md
    quick-reference documents it. sim_walk_gait.py and
    sim_walk_lipm.py --steps 15 both fail against the current model;
    sim_static_pose.py, sim_zmp_balance.py and sim_walk_recede.py --steps 8
    pass. sim_walk_lipm.py's real clean boundary is n=12, not the
    documented n=14.
    Root cause is the same process gap in every case: dca7009 shifted
    z_c/Tc after those gains were tuned, and nothing re-runs the sims on a
    design change -- preflight and both CI workflows run only the cheap
    validators and the rehydration diff, no MuJoCo at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
2026-09-10 Design: populate the actuation envelope and add a 6-axis pelvis IMU
    Two design revisions, both prompted by stepping back over the candidate
    control architectures (see tools/CLAUDE.md and the architecture review).
    actuation.yaml was an empty stub. It now records motor, drivetrain and
    the derived per-joint torque envelope (0.20 N-m stall x 20:1 x 0.70 =
    2.8 N-m). Belt stages are recorded explicitly as 1:1 transmission, not
    reduction -- no belt ratio has ever been specified in this design, and
    the conservative reading yields the smallest envelope, so simulation
    constrains the controller rather than flattering it. Motor stall torque,
    no-load speed and efficiency are marked PLACEHOLDER pending P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
    [actuation.yaml]
2026-09-10 Tooling: source actuation from YAML, emit torque limits and IMU into the models
    Propagates design/actuation.yaml and sensors.yaml's new IMU block through
    the generators and templates.
    Removes three sets of hardcoded numeric design values that violated the
    repo's own rule that such values live only in design/*.yaml:
    - rehydrate_spec.py hardcoded motor model, voltage and count
    - MECH.md.j2 hardcoded "775 brushed DC motors" as template text
    - generate_urdf.py hardcoded effort=100.0 and velocity=1.0, neither of
    which described the real drivetrain
    rehydrate_spec.py now also cross-checks actuation.yaml's motor count
    against the DOF count derived independently from joints.yaml, so the t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
2026-09-10 Design: correct the belt-reduction note -- BOM lists secondary reduction on six joints
    The belt_stage note claimed no belt reduction exists anywhere in the
    design. That is true of design/*.yaml, but BOM.csv lists "Secondary Belt
    Reduction Components" (qty 6) for hip_pitch, hip_roll and knee_pitch on
    both sides. Those six joints are intended to carry a real belt reduction
    of an unspecified ratio; the other seven are not.
    Values are unchanged -- modelling 1:1 uniformly is exact for the seven
    and conservative for the six, which is still the intended conservative
    floor. Only the justification was wrong, and a wrong reason recorded in
    an authoritative file is worth correcting on its own. Also re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
    [actuation.yaml]
2026-09-10 Docs: rehydrate SPEC/MECH for the actuation envelope and IMU, add IMU to BOM
    SPEC gains 6.2 gearbox class and total reduction, 6.3 Output Torque
    Envelope, and 7.3 Inertial Sensing (renumbering F/T sensing to 7.4).
    MECH gains 7.3's belt-transmission-not-reduction statement, 7.4 Output
    Torque Envelope, and 6a Inertial Sensor Integration. All values now come
    from design/*.yaml rather than template literals.
    BOM gains the IMU as a cost-included line. Noting while doing it: root
    CLAUDE.md lists BOM.csv as a derived doc to be regenerated rather than
    edited, but nothing in tools/ generates it -- rehydrate_all.py covers
    SPEC, MECH and README only. This edit was necessarily manual, and the
    gap betwe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
    [BOM.csv]
2026-09-10 Models: regenerate URDF and MJCF with joint torque limits and the pelvis IMU
    MJCF: forcerange +/-2.8 N-m on all 13 position actuators (previously
    absent -- unbounded torque), plus imu_site at the pelvis body origin with
    gyro and accelerometer sensors.
    URDF: joint limits now carry the real effort (2.8 N-m) and velocity
    (78.5 rad/s) from design/actuation.yaml, replacing the placeholder
    effort=100.0 / velocity=1.0.
    Verified: verify_urdf_dimensions.py passes, sim_load_test.py loads and
    steps the model with all 13 actuators.
    Claude-Session: https://claude.ai/code/session_01JfjyLTEHtH1Vw7kgW9Vbj4
    [megadroid_mvs.urdf, megadroid_mvs.xml]
2026-09-10 P3: add a state estimator from measurable signals only; standing survives the torque envelope, walking does not
    state_estimator.py estimates CoM / CoM velocity / DCM from encoders,
    foot F/T and the new pelvis IMU, and from nothing else -- it is scored
    against MuJoCo truth it never reads. Balance-relevant accuracy (CoM
    relative to the stance foot) is 4.58 mm RMS against a 40 mm foot
    half-width and a ~48 mm lateral capturability margin, so the
    observability objection to the model-based architectures is
    substantially answered.
    Found a sign trap getting there: the complementary filter's accelerometer
    correction used cross(up_pred, up_meas), a stable-but-wrong loop that
    parks the estimate at the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
2026-09-10 Docs: Architecture D Stage 0 -- the torque gap is not a servo-gain artifact
    Settled the confound left open by the previous entry. Swept kp against
    the receding-horizon gait under the real 2.8 N-m cap: lowering kp does
    remove the saturation (29.1% of samples at the limit -> 0.4%, RMS 1.78 ->
    0.79 N-m), and the robot still falls at every value tested.
    Why no kp works is the sharper finding. The robot cannot even STAND below
    kp=150 -- and it falls there with torque UNLIMITED too (36.05 deg at
    kp=64), so that failure is pure compliance, not torque. The balanced
    crouch is stable with no active control only while the joints hold it
    near-rigidly; soften them and it sags out of the geometry doing t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
2026-09-10 P3: Architecture D Stage 1 -- constraint-aware LIPM MPC core, self-tested
    Condensed receding-horizon MPC over the LIPM, per axis (the model
    decouples sagittal from lateral, so this is two 1-D problems rather than
    one 2-D one). States are eliminated so the horizon is an affine function
    of the CoP sequence, leaving a box-constrained QP in N variables.
    The point of the architecture is the box. Ankle torque and CoP are the
    same constraint in different units -- tau = F_z * d_CoP -- so the 2.8 N-m
    envelope becomes +-29.7 mm of CoP excursion at full body weight, which is
    tighter than the foot itself (75 mm sagittal, 40 mm lateral). In single
    support the effective support polygon is set by the moto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
2026-09-10 P3: Architecture D Stage 2 -- standing balance MPC; QP is correct, CoP realisation is not
    Negative result, with the failing component identified precisely.
    The plan flagged "realise a desired CoP on a position-controlled robot"
    as the one genuinely unproven step. Measured, it is what failed.
    Feedforward angle offsets sized via servo stiffness deliver gain 0.06
    laterally and are negative-then-unstable sagittally. Closed-loop
    integral tracking of MEASURED ankle torque from the foot F/T sensor does
    work laterally (gain 1.01) -- this is admittance control with a non-zero
    target, exactly what ankle_roll_admittance's tau_x_target was added for
    earlier and left unused. Sagittal resists both becaus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
2026-09-10 Design: set belt reduction to 4:1 on all joints (80:1 total), interim and scoped
    Replaces the 1:1 belt placeholder. 80:1 total gives 11.2 N-m per joint,
    up from 2.8 N-m, and is bounded by two measurements.
    Torque floor: at 20:1 the validated gait clipped its limit on 28.1% of
    samples and fell. Sweeping in simulation, 3x (60:1) is the first ratio
    that walks (6.32 deg, matching the unlimited-torque baseline); 4x leaves
    margin for torque-speed droop (0.4% of samples short vs 1.8% at 3x).
    The belt must include the ankles. BOM listed it on six joints only
    (hip_pitch, hip_roll, knee_pitch); at that scope the gait never walks at
    ANY ratio up to 6x, because raising hip and knee just promotes
    ankle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
    [actuation.yaml]
2026-09-10 Docs: rehydrate for the 80:1 drivetrain; BOM belt now covers all 13 joints
    SPEC/MECH pick up the new total reduction, 11.2 N-m envelope and 19.6
    rad/s joint speed from design/actuation.yaml.
    BOM's "Secondary Belt Reduction Components" goes from 6 joints to 13.
    The six-joint scope (hip_pitch, hip_roll, knee_pitch) was measured to be
    unworkable: at that scope the gait never walks at any ratio up to 6x,
    because raising hip and knee only promotes ankle_pitch to the binding
    joint. Cost rises $72 -> $156.
    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
    [BOM.csv]
2026-09-10 Models: regenerate URDF and MJCF at the 80:1 envelope
    forcerange +-11.2 N-m on all 13 actuators (was +-2.8); URDF joint limits
    effort 11.2 N-m, velocity 19.6 rad/s. Verified: verify_urdf_dimensions
    passes, sim_load_test loads and steps.
    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
    [megadroid_mvs.urdf, megadroid_mvs.xml]
2026-09-10 Docs: record the 80:1 drivetrain decision and what it recovers
    The 80:1 envelope recovers the primary walking milestone --
    sim_walk_recede --steps 8 goes from a 77.59 deg fall to walking at
    8.76 deg. Static pose and ZMP balance still pass.
    The other two gaits do not recover, and not for torque reasons.
    sim_walk_lipm demands only 7.23 N-m p95 against an 11.2 envelope and
    clips on 0.1% of samples, yet still falls -- the same knife-edge
    sensitivity documented elsewhere in this file. sim_walk_gait's failure
    has its own separate root cause.
    Also records the evidence behind the ratio: the torque-floor sweep, the
    finding that the belt must include the ankles or no ratio works, the CMU
    motion-capt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
2026-09-10 Docs: CoP-repulsion exhausted -- re-tested with a working actuation path, and worse than baseline
    Re-opened CoP-repulsion because the 80:1 drivetrain and Stage 2's
    realisation findings made the earlier negative result inconclusive. It
    now closes properly, with the original null finally explained.
    The explanation is the actuation path. A full-foot 40mm CoP demand is
    3.77 N-m, which through ankle_roll_admittance's proportional law at
    K_ADM_RECEDE=5000 yields 0.043 degrees of ankle_roll. The mechanism was
    mis-plumbed rather than ineffective -- no gain or sign could have made it
    act. Stage 2 measured the same thing by a different route (proportional
    realisation gain 0.06, integral 1.01).
    Re-ro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
2026-09-10 Docs: capture-region footstep placement is a false positive; eighth approach closes
    Architecture E, the last untried mechanism of the eight and the one the
    80:1 envelope plausibly unblocked. Built as Koolen/Pratt Algorithm 1 in
    spirit -- move the nominal footstep only as far as needed to land inside
    the predicted capture region, rather than always chasing the capture
    point and clamping the delta.
    At the standard push_at=2.0s it survived 20N at 7.35 deg where the
    committed law falls at 90.31, which would have been this project's first
    real push-recovery improvement. It does not survive the timing check:
    across seven push timings both configs survive exactly 1/7 at 20N, just
    with the lucky ce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
2026-09-10 P3: per-axis DCM gain -- clean walking range doubles from 8 to 16 steps
    Chasing the inverse-dynamics discrepancy led to a check this codebase had
    never run: compare the robot's ACTUAL centre-of-mass trajectory against
    the one its own planner asked for. The two axes behave completely
    differently.
    sagittal: actual sway 96% of planned amplitude -- tracking fine
    lateral : actual sway 215% of planned amplitude -- over-swinging 2x
    K_DCM_RECEDE was applied to both axes as a single shared value. Correct
    for sagittal, badly wrong for lateral: the CoM was routinely swinging
    past both the 40mm foot half-width and the 37.8mm capturability margin
    during NORMAL walking, meaning the stability margin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
2026-09-10 Docs: record the lateral over-swing finding, the fix, and what it does not fix
    The robot was never following its own planned CoM trajectory. Comparing
    actual against planned -- a check never run in this project -- shows
    sagittal tracks at 96% of planned sway amplitude while lateral overswings
    to 151-215%, during clean walking. Phase lag ruled out; it is an
    amplitude failure. At 85mm peak-to-peak the CoM routinely passes both the
    40mm foot half-width and the 37.8mm capture margin as normal operation.
    Root cause was K_DCM_RECEDE applied to both axes as a single value. Fixed
    with a separate lateral gain scaled UP (tighter tracking, smaller error),
    committed as f63ad0d: clean walking range doub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
2026-09-10 Design: specify sole contact compliance -- the MJCF was modelling a rigid foot
    BOM.csv has always specified a "Flat Sole Plate Assembly (compliant sole
    pad) -- rigid plate + compliant pad for vertical shock absorption", but
    generate_mjcf.py emitted the foot as a rigid box on a rigid plane with
    default contact parameters. The simulation was modelling a robot that was
    never designed.
    sim_zmp_balance.py's docstring had already observed the consequence
    without connecting it: MuJoCo box-plane contact "activates different
    corner subsets frame to frame". That is discontinuous ground reaction --
    noise in the physics, not the sensor -- and it was filtered rather than
    fixed.
    Contact compliance turns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
    [geometry.yaml]
2026-09-10 Models: regenerate MJCF with the compliant sole (solref 0.05 1.0)
    Foot geoms carry sole compliance instead of rigid-default contact.
    Full P3 battery re-verified: sim_load_test, sim_static_pose,
    sim_zmp_balance and sim_walk_recede --selftest all pass; receding-horizon
    nominal walking flat at 6.69 deg across n=8/12/16 with n=20 marginal
    (20.99). sim_walk_lipm and sim_walk_gait still fail, unchanged -- their
    causes are separate and already documented.
    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
    [megadroid_mvs.xml]
2026-09-10 Docs: the chaos was substantially a modelling artifact, not robot behaviour
    Records the sole-compliance finding and what it invalidates.
    BOM always specified a compliant sole pad; the MJCF modelled a rigid box
    on a rigid plane. sim_zmp_balance.py's docstring had already noticed the
    consequence -- box-plane contact activating different corner subsets
    frame to frame -- and filtered it as sensor noise rather than recognising
    discontinuous ground reaction as noise in the physics.
    Compliance dominates disturbance behaviour: 10N push survival goes 0/12
    rigid to 9/12 at solref 0.05, after eleven control mechanisms had failed
    to move it at all. The character changes too -- rigid contact alternates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
2026-09-10 Docs: P3 milestone -- simulation fidelity, not control theory, was the blocker
    Adds docs/P3_MODEL_FIDELITY.md recording the central finding of Stage P3
    and its consequences for the development plan, and points the root
    CLAUDE.md P3 section at it.
    Eleven structurally different control mechanisms were built and failed
    against push recovery, and the conclusion drawn was that the architecture
    had hit a real limit. That was wrong. Four separate simulation defects
    were then found, each invisible until measured and each able on its own
    to invalidate what was built on it: no actuator torque limits,
    controllers consuming privileged CoM state the real sensor suite cannot
    observe, control gains left s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
2026-09-10 Docs: both provisional verdicts re-tested against compliant contact -- confirmed
    CoP-repulsion: CONFIRMED exhausted. K_IC swept both signs across 11
    timings at 4 magnitudes; best case differs from baseline by one cell in
    twelve, in both directions. Stays inert at 0.0, now on a verdict reached
    against a contact model that does not flip on a 10ms perturbation.
    Capture-region footstep placement: CONFIRMED, more strongly than the
    original. Both region sizes break nominal walking at n=16 and are equal
    or worse on every push magnitude. Its one redeeming feature under rigid
    contact -- mildly better nominal walking -- reverses entirely, so rigid
    contact was misleading in both directions, not only t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
2026-09-10 Docs: scope the single-joint test rig for P4 envelope verification
    Adds docs/P4_JOINT_TEST_RIG.md and cross-references it from the P3
    model-fidelity report.
    Six authoritative values are still guesses, and this session showed four
    times that a guessed value produces a confident wrong conclusion. None
    are resolvable by more simulation. The rig measures one joint built from
    the robot's own parts so the numbers transfer.
    Seven tests, each mapped to the specific design/*.yaml field it replaces:
    torque-speed curve (stall torque, no-load speed, the droop the flat
    forcerange does not model, and direct verification of the inferred 4:1
    belt ratio), efficiency, thermal continuous rating, backlash and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
2026-09-10 Docs: survey existing open test-rig designs against the P4 rig spec
    Nothing off-the-shelf matches whole, but the rig splits in two and the
    better prior art is on the half that isn't a dynamometer.
    The filter: published motor dynos measure at the motor shaft (high RPM,
    low torque) and size their absorbers for that regime. Test A measures at
    the joint output after the full reduction -- low speed, high torque, the
    inverse. Instrumentation transfers, loading mechanisms don't.
    Per-test mapping added: Capo01's ODrive dyno (pivot-arm load cell, split
    current shunts) and the Cambridge drone society stand for A/B/C; the
    UART-servo backlash stand for D; the Open-Pull/UMTK universal-testing
    family fo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
2026-09-10 Docs: locate the RAPID files, and correct the rig's cost driver
    Two corrections to the prior-art section committed in a149c0b.
    RAPID's files exist. The URL the paper gives (robotics.ucsd.edu/dyno) is
    dead -- the Wayback Machine holds one capture of it, from 2024, already a
    404 -- but the archive survives as Supplemental File 5 of the lead
    author's dissertation on eScholarship, open access. Retrieved into
    reference-material/ (gitignored): full BOM, 9 STL + 2 DXF of the
    mechanical assembly, 3 parametric SolidWorks adapter plates, and the
    LabVIEW project. Doc now carries the direct URL.
    Reading the paper rather than the abstract also sharpens what RAPID
    cannot do for us, from two limits to th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
2026-09-10 CI: gate the P3 simulation milestones in preflight and GitHub Actions
    Closes the process gap the P3 milestone audit identified and deliberately
    left open, on the grounds that "fixing it requires first restoring a
    passing baseline for the two broken commands, otherwise the gate lands
    red." That precondition is now met: sim_walk_lipm's selftest is green
    again, and sim_walk_gait is excluded on its merits.
    The gap was real and was paid for three times. preflight and both
    existing workflows ran only the cheap validators and the rehydration
    diff -- no MuJoCo -- so a design/*.yaml edit could invalidate every
    walking claim in the repo, pass all gates, and merge clean. dca7009 did
    exactly that, and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
2026-09-11 Design: record why the F/T sensor cost exclusion is near-zero, not out-of-scope
    design/sensors.yaml's end_of_limb_sensing.ft_sensor has carried
    cost_accounting: excluded since it was written, with no rationale field --
    unlike the IMU, added the same day, which does have one. The gap was never
    a design decision to hide; the justification simply hadn't been written
    down, in violation of this file's own header ("Do not duplicate values...
    Changes require SPEC.md revision").
    The user's actual plan: each foot's 6-DOF sensor is six load cells
    harvested from used Wii Fit Balance Boards (four bar-type cells per
    board, unusual among human-rated force devices), arranged Stewart-platform
    style between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
2026-09-11 Docs: rehydrate SPEC/MECH for the F/T sensor cost rationale
    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
    [BOM.csv]
2026-10-18 Design: record plausible low/high bounds for the unmeasured placeholders
    Adds a sibling estimate_ranges block to design/actuation.yaml and
    design/geometry.yaml. Every scalar is unchanged and stays the NOMINAL that
    all tools use; the ranges sit alongside with a basis for each bound.
    Midpoints are derived by tooling, never stored, so there is still one
    source of truth.
    Motivation: the P4 test rig is a physical bottleneck, and the placeholders
    (motor stall torque, drivetrain efficiency, sole compliance) have each
    produced a confident wrong conclusion before. Bounding them from existing
    information lets simulation say which conclusions survive the whole
    plausible range and which flip inside it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
2026-10-18 Sim: sensitivity sweep over the ranged placeholders -- the sole decides, torque does not
    tools/sweep_estimates.py builds each model in memory from overridden design
    data (the committed MJCF is never touched) and runs standing, both walking
    controllers, and a 12-timing lateral push battery across low/mid/high of the
    ranged placeholders plus the current nominal. 16 points, ~7 minutes. The
    baseline row reproduces the gate exactly (0.30 / 6.82 / 6.69).
    Results, recorded in tools/CLAUDE.md with the full table:
    - Robust: standing passes at all 16 points; 8-step walking passes at every
    torque for sole 0.03-0.055.
    - Flips: everything else -- lipm10, 16-step walking, both push batteries.
    - The st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
2026-10-19 Design: correct the sole range basis -- stiffness is E*A/t, so the window is not a material
    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
2026-10-21 Design: add pelvis.hip_spacing_mm (175), decoupled from the twin-rail gap
    The sim and URDF took hip spacing as half of twin_rail.inner_face_spacing_mm, which
    is the rail gap inside one leg. 175 mm follows Hubo's ~177 mm (third-party URDF,
    estimate), and leaves ~86 mm between two 88.85 mm hexagonal F/T sensors.
    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
2026-10-21 Tools: read hip spacing from the YAML; retire sim_walk_lipm's end-to-end walk from the gate
    The walk fell at every step count at 175 mm and is superseded by sim_walk_recede,
    which walks unretuned. Stages 0-5c stay as the shared-machinery selftest.
    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
2026-10-21 URDF/MJCF: regenerate for 175 mm hip spacing
    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
2026-10-21 Sim: foot width x sensor mass sweep; log the hip-spacing revision
    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
2026-10-21 Design: F/T sensor is a hexagonal prism (88.85 mm across flats, 57.544 mm); add ft_sensor.yaml study inputs
    Envelope taken from the builder's CAD concept. Cell dimensions are measured;
    the rating is from reseller listings and unverified until Test H.
    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
2026-10-21 Docs: rehydrate for the hexagonal F/T sensor form factor
    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
2026-10-21 Tools: log foot F/T loads from the sim; score sensor layouts on them
    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
2026-10-21 Design: record the unmeasured load-path fraction of the bolted-both-ends cell concept
    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
2026-10-21 Docs: Test H2/H3 -- does a cell bolted at both ends still measure?
    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
2026-10-21 Design: margin and clearance in ft_sensor.yaml match the builder's concept
    The 3 mm wall margin and 1.5 mm clearance rejected the concept's own geometry.
    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
2026-10-21 Design: separate sensing-range and abuse loads; sizing basis for the F/T sensor rods
    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
2026-10-21 Hardware: closed-form sizing (flexure necks, bolts, pads); thinner caps give a layout that fits the spec hexagon
    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
2026-10-21 Design: 12.9 bolts, 12.7 mm pad; record that a central pin stop is impractical
    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
2026-10-21 Hardware: stop and structure sizing; joint, overload and wedge-block results
    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
2026-10-21 Design: F/T sensor envelope is the 88.85 mm hexagon; lathe and CNC access recorded
    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
2026-10-21 Hardware: synthesis counts the far-end boss as not-rod; the earlier inversion candidate had a 10.8 mm free rod
    The boss that seats the rod's far shoulder (about 8 mm deep along the axis at 54.7 deg) was inside the
    span the search counted as rod, so the published candidate failed its own sizing. Free rod is now span - boss depth.
    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
2026-10-21 Design: F/T sensor build candidate (3 mm caps, threaded rod end, 2.4 x 4.5 mm necks)
    The layout and main part dimensions the CAD model is built from. Supersedes the 6 mm-cap inversion
    candidate, whose far-end boss was counted as rod length.
    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
2026-10-21 Hardware: solid CAD model of the F/T sensor (STEP), build guide, checks
    cad_build.py builds every part with build123d and checks interference, envelope, hole wall, tool access and
    assembly order on the solids. The layout search now models rod hex ends, screw heads and key access. Removes the
    stale box-model scene exporter.
    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
2026-10-21 Hardware: keep the original Stewart concept STEP as the development starting point; update the F/T sensor README
    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
2026-10-22 Hardware: CAD models for the bench test rigs (H, H off-axis, H2, H3, R) on one shared tower
    Adds bench_rigs_build.py, BENCH_RIGS.md and cad/bench_rigs/ (five rig STEP files,
    machined parts, parts list, checks). Updates BENCH_TEST_STRUT.md to the current rod
    and the README index.
    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
2026-10-24 Hardware: bill of materials and shared stock cut plan for one F/T sensor and the bench rigs
    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
2026-10-28 Design: legs go from 5 to 6 actuated DOF (add hip yaw); MVS is now 15 joints
    Hip chain is yaw -> roll -> pitch with concurrent axes, so leg kinematics are
    unchanged at yaw = 0. Hip yaw uses the uniform 80:1 drivetrain and 11.2 N.m cap.
    Total mass estimate 9.6 -> 10.6 kg.
    Tooling: MJCF/URDF generators add the hip yaw link and joint; state estimator
    and joint checker follow the new count. The added mass raised the CoM, so the
    verified z_c/Tc constants in the LIPM selftest are updated, and the recede
    walker gains are re-tuned (-0.92 / 1.1 / 7500) to keep nominal walking clean
    through 40 steps. Push survival drops to 11/24 (was 19/24 with 5-DOF legs);
    see tools/CLAUDE.md 2026-10-27. Hip yaw is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
2026-10-28 Docs: rehydrate SPEC and MECH for 6-DOF legs; BOM for 15 joints
    BOM motors, gearboxes, belts and encoders 13 -> 15; included total $1,471.
    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
2026-10-28 Simulation: regenerate URDF and MJCF with hip yaw joints
    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
2026-10-28 Tools: re-tune recede walker for push survival on 6-DOF legs (-0.89 / 0.69 / 5000)
    Push-first search over 108 gain sets: 17/24 pushes (was 11/24 with the
    nominal-first retune; 5-DOF baseline 19/24). Unpushed walking is clean through
    25 steps (was 40; 5-DOF baseline 16). Sim gate passes.
    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
2026-10-28 Design: record F/T loads re-logged on the 6-DOF model with final gains, and the sizing re-run
    Design-basis peak values unchanged. Fz peak is +18% (205.8 N); the build
    candidate still passes with less buckling margin.
    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
